7taras/LantronixSTALT/Datasheets/ENC28J60/enc28j60-ethernet-board-2_5.jpg

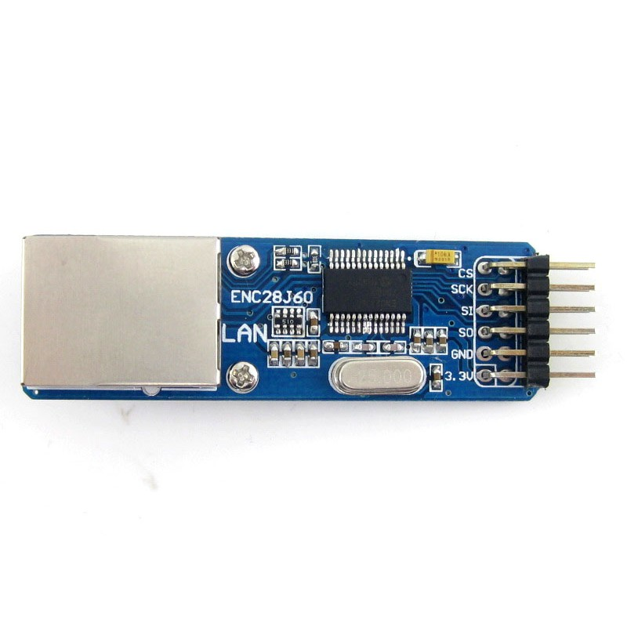
Datasheets/ENC28J60/enc28j60-ethernet-board-2_5.jpg
