7taras/LantronixSTALT/Datasheets/ENC28J60/enc28j60-ethernet-board_l_1_5.jpg

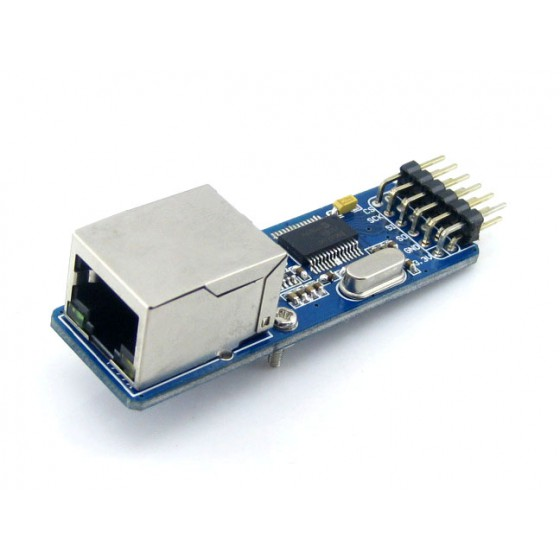
Datasheets/ENC28J60/enc28j60-ethernet-board_l_1_5.jpg
