7taras/LantronixSTALT/Project_v2/АСТА.468353.020 ПЭ3_00.pdf

Èçì. Ëèñò | | ¹ äîêóì. | Пîäï. | Äàòà
| | Ðàçðàá. | Кàлнàгóç | | 1.05.23 | Плàòà UART-Ethernet Пеðечень элеìенòîв | Ëèò. | Ëèñò | Ëèñòîв
Пðîв. | Аêáàшев | | 1.05.23 | | | | | 1 3
Í.êîнòð. | Цèðценñ
Óòв. | Íеñèн
ООО"СТАËТ" Èнв. ¹ ïîäл. Пîäï. è äàòà Âçàì. èнв. ¹ Èнв. ¹ äóáл. Пîäï. è äàòà Сïðàв. ¹ Пеðв. ïðèìен. | АСТА.468353.020 | A1 | Ðîçеòêà HR911105A, HanRun | 1
BQ1 | Квàðцевый ðеçîнàòîð HС-49S 12 МГц | 1
BQ2 | Квàðцевый ðеçîнàòîð HС-49S 25 МГц | 1

Кîнäенñàòîðы

C1 | Тàнòàлîвый SMD 47 ìêФ ±10% 10 Â Case B | 1
C2 | SMD 0805 X7R 1 ìêФ ±10% 50 Â | 1
C3 | Тàнòàлîвый SMD 47 ìêФ ±10% 10 Â Case B | 1
C4 | SMD 0805 X7R 1 ìêФ ±10% 50 Â | 1
C5,C6 | SMD 0805 NPO 18 ïФ ±5% 50 Â | 2
C7-C11 SMD 0805 X7R 0,1 ìêФ ±10% 50 Â | | 5
C12,C13 SMD 0805 NPO 18 ïФ ±5% 50 Â | | 2
C14 | SMD 0805 X7R 0,01 ìêФ ±10% 50 Â | 1
C15-C18 SMD 0805 X7R 0,1 ìêФ ±10% 50 Â | | 4
C19 | SMD 1206 X7R 4,7 ìêФ ±10% 50 Â | 1
C20,C21 SMD 0805 NPO 6800 ïФ ±5% 50 Â | | 2
C22 | SMD 0805 X7R 0,022 ìêФ ±10% 50 Â | 1
С23 | SMD 0805 X7R 0,01 ìêФ ±10% 50 Â | 1
C24 | SMD 1812 X7R 2200 ïФ ±10% 2 êÂ | 1
| Мèêðîñхеìы
DA1 | Сòàáèлèçàòîð AMS1117-3.3, AMS (SOT-223) | 1
DD1 | Мèêðîêîнòðîллеð STM32F103RB, | 1
| STMicroelecronics (LQFP-64 10x10mm)
DD2 | Мèêðîñхеìà W5500, Wiznet (LQFP-48 7x7mm) | 1
| | | АСТА.468353.020 ПЭ3

Пîç.
îáîçнàченèе
Íàèìенîвàнèе | Кîл. Пðèìечàнèе
Кîïèðîвàл | Фîðìàò A4

АСТА.468353.020 ПЭ3 | Ëèñò
| 2
HL1,Hl2 Свеòîäèîä KPTD-3216MGC | | 2
HL3 | Свеòîäèîä FYLS-1206SRC | 1
HL4 | Свеòîäèîä KPTD-3216MGC | 1
L1,L2 | Äðîññель BLM21BD121SN1D | 2
| Ðеçèñòîðы
R1 | SMD 0805 3 êОì ±5% | 1
R2,R3 | SMD 0805 33 Оì ±1% | 2
R4-R7 SMD 0805 10 êОì ±5% | | 4
R8 | SMD 0805 1 êОì ±5% | 1
R9 | SMD 0805 1 МОì ±5% | 1
R10-R12 SMD 0805 10 êОì ±5% | | 3
R13,R14 SMD 0805 1 êОì ±5% | | 2
R15 | SMD 0805 1 МОì ±5% | 1
R16-R18 SMD 0805 10 êОì ±5% | | 3
R19 | SMD 0805 12,4 êОì ±1% | 1
R20-R23 SMD 0805 33 Оì ±1% | | 4
R24-R27 SMD 0805 49,9 Оì ±1% | | 4
R28 | SMD 0805 10 Оì ±1% | 1
Èçì. Ëèñò R29,R30 SMD 0805 1 êОì ±5% | ¹ äîêóì. Пîäï. Äàòà Èнв. ¹ ïîäл. Пîäï. è äàòà Âçàì. èнв. ¹ Èнв. ¹ äóáл. Пîäï. è äàòà | 2
VD1 | Äèîä SMAJ5.0A (SMA (DO-214AC)) | 1
VT1,VT2 Тðàнçèñòîð BSS138 (SOT-23) | 2
X1 | Ðîçеòêà PBS-4 | 1
X2 | Âèлêà PLS-2 | 1 | не óñòàнàвлèвàòь

АСТА.468353.020 ПЭ3 | Ëèñò
3 Èçì. Ëèñò | ¹ äîêóì. | Пîäï. | Äàòà Èнв. ¹ ïîäл. Пîäï. è äàòà Âçàì. èнв. ¹ Èнв. ¹ äóáл. Пîäï. è äàòà

Пеðеìеные äàнные äля èñïîлненèй:

АСТА.468353.020

XP1 | Âèлêà IDC-10MS (BH-10) | 1
| АСТА.468353.020-01
XP1 | Âèлêà PLS-10 | 1
XP2 | Âèлêà PLS-2 | 1
