7taras/LantronixSTALT/Project_v2/АСТА.758723.038 УД_00.pdf

# АСТА.758723.038 УД

Изм. Лист | | № докум. | Подп. | Дата
| | Разраб. | Калнагуз | | Плата печатная Удостоверяющий лист | Лит. | Лист | Листов
Пров. | Акбашев | | | | | | | 1
Н.контр. | Цирценс
Утв. | Несин
ООО"СТАЛТ" Инв. № подл. Подп. и дата Взам. инв. № Инв. № дубл. Подп. и дата Справ. № Перв. примен. | АСТА.468353.020
Копировал | Формат A4
Обозначение | Разработал | Изготовил | Согласовано | Утвердил

АСТА.758723.038_V2.GBL
АСТА.758723.038_V2.GBO
АСТА.758723.038_V2.GBS
АСТА.758723.038_V2.GM4
АСТА.758723.038_V2.GTL
АСТА.758723.038_V2.GTO
АСТА.758723.038_V2.GTS
АСТА.758723.038_V2-Plated.txt
Калнагуз | Несин
