7taras/LantronixSTALT/Project2/АСТА.758723.039 УД_00.pdf

# АСТА.758723.039 УД

Изм. Лист | | № докум. | Подп. | Дата
| | Разраб. | Калнагуз | | 1.06.23 | Плата печатная Удостоверяющий лист | Лит. | Лист | Листов
Пров. | Акбашев | | 1.06.23 | | | | | | 1
Н.контр. | Цирценс
Утв. | Несин
ООО"СТАЛТ" Инв. № подл. Подп. и дата Взам. инв. № Инв. № дубл. Подп. и дата Справ. № Перв. примен. | АСТА.468353.020
Копировал | Формат A4
Обозначение | Разработал | Изготовил | Согласовано | Утвердил

АСТА.758723.039_V1.GBL
АСТА.758723.039_V1.GBO
АСТА.758723.039_V1.GBS
АСТА.758723.039_V1.GM4
АСТА.758723.039_V1.GTL
АСТА.758723.039_V1.GTO
АСТА.758723.039_V1.GTS
АСТА.758723.039_V1-Plated.txt
Калнагуз | Несин
