7taras/LantronixSTALT/Legacy/АСТА.468353.016 Плата Пи-Ethernet/АСТА.468353.016 ПЭ3_02.pdf

2 | Зам. АСТА.3062
Èçм. Ëèñò | | ¹ äîêóм. | Пîäï. | Äаòа
| | Ðаçðаá. | Кîнîвалîв | | | Плаòа ПÈ-Ethernet Пеðечень элеменòîв | Ëèò. | Ëèñò | Ëèñòîв
Пðîв. | Калнагóç | | | | О 1 | | | 1 2

Í.êîнòð. Цèðценñ
Óòв. | Гðèçóн
ООО "СТАËТ" Èнв. ¹ ïîäл. Пîäï. è äаòа Âçам. èнв. ¹ Èнв. ¹ äóáл. Пîäï. è äаòа | 8865 30.10.13 Сïðав. ¹ Пеðв. ïðèмен. | АСТА.468353.0¹6 | Кîнäенñаòîðы
С1-С3 | Танòалîвый SMD 10 мêФ ±10% 6,3 Â Size A | 3
С4,С5 | SMD 0805 X7R 0,1 мêФ ±10% 50 Â | 2
| Мèêðîñхемы
D1 | TXSO104EDR (SOIC-14) | 1
DA1 | LM1086ISX-3.3 (TO-263) | 1
| Свеòîäèîäы
HL1 | L-C150YCT | 1
HL2 | L-C150GCT | 1
| Ðеçèñòîðы
R1 | SMD 0805 10 êОм ±5% | 1
R2,R3 | SMD 0805 1 êОм ±5% | 2
R4,R5 | SMD 0805 10 êОм ±5% | 2
SB1 | Кнîïêа òаêòîвая 0643
| Пеðеменные äанные äля èñïîлненèй:
| АСТА.468353.016
С6,С7 | SMD 1210 NPO 220 ïФ ±5% 3 êÂ | 2
| Сîеäèнèòелè
XP1 | Âèлêа BH-10G | 1
XP2 | XP1002000-05R | 1
| | | АСТА.468353.016 ПЭ3

Пîç.
îáîçначенèе
Íаèменîванèе | Кîл. Пðèмечанèе
Кîïèðîвал | Фîðмаò A4

АСТА.468353.016 ПЭ3 | Ëèñò
| 2
2 | Íîв. АСТА.3062 Èнв. ¹ ïîäл. Пîäï. è äаòа Âçам. èнв. ¹ Èнв. ¹ äóáл. Пîäï. è äаòа | Èçм. Ëèñò | ¹ äîêóм. | Пîäï. | Äаòа ¹³⁴⁶⁶ ²⁶.06.18

АСТА.468353.016-01

| Сîеäèнèòелè
XP1,XP2 Âèлêа PLS-10 | | 2
XP3 | XP1002000-05R | 1

АСТА.468353.016-02

C6,C7 | SMD 1210 NPO 220 ïФ ±5% 3 êÂ | 2
| Сîеäèнèòелè
XP1 | Âèлêа BH-10G | 1
XP2 | XP1002000-05R | 1

Пîç.
îáîçначенèе
Íаèменîванèе | Кîл. Пðèмечанèе
Кîïèðîвал | Фîðмаò A4
