7taras/LantronixSTALT/Legacy/АСТА.468353.016 Плата Пи-Ethernet/АСТА.468353.016_04.pdf

| | | | | АСТА.468353.016
4 | Зам. АСТА.3062
Изм. Лист | | № докум. | Подп. | Дата
Разраб. | Коновалов | | | Плата ПИ-Ethernet | Лит. | Лист | Листов
Пров. | Калнагуз | | | | О 1 | | | 1 4
Т.контр. Михайлов | | | | | ООО "СТАЛТ"
Н.контр. Цицренс
Утв. | Гризун
Инв. № подл. | Подп. и дата | Взам. инв. № | Инв. № дубл. | Подп. и дата
8867 30.10.2013
| АСТА.468353.016- | Примечание
Справ. № | Перв. примен.
А4 | АСТА.468353.016 СБ | Сборочный чертеж | X | | (Л⁾ X | АСТА.425529.032 Код Лит.
A4 | -01 СБ | Сборочный чертеж | | X
А3 | АСТА.468353.016 Э3 | Схема электрическая | X | | X
| | принципиальная
A3 | -01 Э3 | Схема электрическая | | X
| | принципиальная
| | | | Документация
А4 | Зона | Поз. | АСТА.468353.016 ПЭ3 Обозначение | Перечень элементов Наименование | Кол. на исполн. X | X | X Формат
- 01 02
Копировал | Формат A4

АСТА.468353.016 | Лист
2

4 Зам. АСТА.3062
Изм. Лист | № докум. | Подп. | Дата

8867 30.10.2013
| АСТА.468353.016- | Примечание

Детали

А4 | 1 АСТА.754312.528 | Этикетка | 1
БЧ | 3 АСТА.758723.034 | Плата печатная | 1 | | 1
БЧ | 3 АСТА.758723.035 | Плата печатная | | 1

Прочие изделия

Конденсаторы

6 | Танталовый SMD 10 мкФ ±10% 6,3 В Size A | 3 | 3 | 3 | С1-С3 Формат | Зона | Поз. | Обозначение | Наименование | Кол. на исполн.
- 01 02
А4 | АСТА.468353.016 И1 | Инструкция по проверке | X | X | X
А4 | АСТА.758723.034 УД | Удостоверяющий лист | X | | X | Плата
А4 | АСТА.758723.035 УД | Удостоверяющий лист | | X | | Плата

3

### 4 Нов. АСТА.3062

8867 30.10.2013
| АСТА.468353.016- | Примечание
Зона | 17 Поз. | Обозначение | SMD 0805 1 кОм ±5% Наименование Микросхемы | Кол. на исполн. 2 | 2 | 2 | R2,R3 Формат
| 10 | | TXS0104EDR (SOIC-14) | 1 | 1 | 1 | D1
| 11 | | LM1086ISX-3.3 (TO-263) | 1 | 1 | 1 | DA1
| Светодиоды
13 | L-C150YCT | 1 | 1 | 1 | HL1
14 | L-C150GCT | 1 | 1 | 1 | HL2
| Резисторы
16 | SMD 0805 10 кОм ±5% | 3 | 3 | 3 | R1,R4,R5
- 01 02
| 7 | SMD 0805 X7R 0,1 мкФ ±10% 50 В | 2 | 2 | 2 | С4,С5
| 8 | SMD 1210 NPO 220 пФ ±5% 3 кВ | 2 | | 2 | С6,С7

4

### 4 Нов. АСТА.3062

8867 30.10.2013
| АСТА.468353.016- | Примечание
| Соединители
22 | Вилка BH-10G | 1 | | 1 | XP1 к баз.,-02
23 | XP1002000-05R | 1 | 1 | 1 | XP2 к баз.,-02,
| | | | | XP3 к -01
- 01 02
| | 20 | | Кнопка тактовая 0643 | 1 | 1 | 1 | SB1
| Зона | 24 Поз. | Обозначение | Вилка PLS-10 Наименование | Кол. на исполн. | 2 | | XP1, XP2 к -01 Формат
