7taras/LantronixSTALT/Legacy/АСТА.468353.018 Плата ПИ-Ethernet-MX/АСТА.468353.018 ПЭ3_00.pdf

Èçì. Ëèñò | | ¹ äîêóì. | Пîäï. | Äàòà
| | Ðàçðàá. | Кàлнàгóç | | 18.11.19 | Плàòà ПÈ-Ethernet-MX Пеðечень элеìенòîв | Ëèò. | Ëèñò | Ëèñòîв
Пðîв. | Кîнîвàлîв | | 18.11.19 | | | | | 1 2

Í.êîнòð. Цèðценñ
Óòв. | Гðèçóн
ООО"СТАËТ" Èнв. ¹ ïîäл. Пîäï. è äàòà Âçàì. èнв. ¹ Èнв. ¹ äóáл. Пîäï. è äàòà Сïðàв. ¹ Пеðв. ïðèìен. | АСТА.468353.0¹8 | A1, A2 Óñòðîйñòвî XP1002000-05R | 2
| Кîнäенñàòîðы
C1, C2 SMD 1210 NP0 220 ïФ ±5% 3 êÂ | | 2
С3 | Тàнòàлîвый SMD 22 ìêФ ±10% 6,3 Â Case A | 1
C4 | SMD 0805 X7R 1 ìêФ ±10% 50 Â | 1
C5 | SMD 0805 X7R 0,1 ìêФ ±10% 50 Â | 1
С6 | Тàнòàлîвый SMD 22 ìêФ ±10% 6,3 Â Case A | 1
C7 | SMD 0805 X7R 1 ìêФ ±10% 50 Â | 1
C8-C13 SMD 0805 X7R 0,1 ìêФ ±10% 50 Â | | 6
| Мèêðîñхеìы
DA1 | AMS1117 (SOT-223) | 1
DD1 | 74HC257D (SOIC-16) | 1
DD2 | TXS0104EPWR (TTSOP-14) | 1
| Свеòîäèîäы
HL1,HL2 L-C150GCT | | 2
HL3,HL4 L-C150YCT | | 2
HL5-HL7 L-C150GCT | | 3
HL8,HL9 L-C150YCT | | 2
| Ðеçèñòîðы
R1 | SMD 0805 3 êОì ±5% | 1
R2,R3 | SMD 0805 10 êОì ±5% | 2
R4-R6 SMD 0805 3 êОì ±5% | | 3
R7 | SMD 0805 220 Оì ±1% | 1
R8 | SMD 0805 360 Оì ±1% | 1
| | | АСТА.468353.018 ПЭ3

Пîç.
îáîçнàченèе
Íàèìенîвàнèе | Кîл. Пðèìечàнèе
Кîïèðîвàл | Фîðìàò A4

АСТА.468353.018 ПЭ3 | Ëèñò
2 Èнв. ¹ ïîäл. Пîäï. è äàòà Âçàì. èнв. ¹ Èнв. ¹ äóáл. Пîäï. è äàòà | Èçì. Ëèñò | ¹ äîêóì. | Пîäï. | Äàòà
SB1,SB2 Кнîïêà òàêòîвàя 0643 | 2
| Äèîäы
VD1 | SMAJ5.0A (SMA (DO-214AC)) | 1
VD2 | SMLVT3V3 (SMB (DO-214AA)) | 1
XP1 | Âèлêà IDC-10MS (BH-10) | 1
Пîç. îáîçнà-ченèе | Íàèìенîвàнèе | Кîл. Пðèìечàнèе
R9-R13 SMD 0805 1 êОì ±5% | | 5
R14-R16 SMD 0805 10 êОì ±5% | | 3
R17 | SMD 0805 1 êОì ±5% | 1
R18 | SMD 0805 10 êОì ±5% | 1
R19 | SMD 0805 1 êОì ±5% | 1
Кîïèðîвàл | Фîðìàò A4
