7taras/LantronixSTALT/Legacy/АСТА.468353.018 Плата ПИ-Ethernet-MX/АСТА.468353.018_00.pdf

## АСТА.468353.018

Изм. Лист | | № докум. | Подп. | Дата
Разраб. | Калнагуз | | 18.11.19 | Плата ПИ-Ethernet-MX | Лит. | Лист | Листов
Пров. | Коновалов | | 18.11.19 | | | | | 1 4
Т.контр. Михайлов | | | | | ООО"СТАЛТ"
Н.контр. Цирценс
Утв. | Гризун
| | | | Документация
Инв. № подл. А4 | Зона | Поз. | Подп. и дата Взам. инв. № Инв. № дубл. АСТА.758723.037 УД Обозначение | Подп. и дата Удостоверяющий лист Наименование | Кол. на исполн. X | (Л⁾ X Формат | Справ. № | Перв. примен. Код Лит.
A3 | ACTA.468353.018 СБ | Сборочный чертеж | X | X
A3 | ACTA.468353.018 Э3 | Схема электрическая | X | X
| | принципиальная
А4 | ACTA.468353.018 ПЭ3 | Перечень элементов | X | X
А4 | ACTA.468353.018 И1 | Инструкция по настройке | X | X
| | и проверке
- 01
АСТА.468353.018- | Примечание
Копировал | Формат A4

АСТА.468353.018 | Лист
2
Изм. Лист | № докум. | Подп. | Дата
Инв. № подл. | Подп. и дата | Взам. инв. № | Инв. № дубл. | Подп. и дата

Детали

A4 | 1 АСТА.754312.520 | Этикетка | 1 | 1
БЧ | 2 АСТА.758723.037 | Плата печатная | 1 | 1

Прочие изделия

18 | Устройство XP1002000-05R | 2 | 2 | A1,A2
| Конденсаторы
20 | SMD 0805 X7R 0,1 мкФ ±10% 50 В | 7 | 7 | C5,C8-C13
21 | SMD 0805 X7R 1 мкФ ±10% 50 В | 2 | 2 | C4,C7 Формат | Зона | Поз. | Обозначение | Наименование | Кол. на исполн.
- 01
АСТА.468353.018- | Примечание

| | | 3 Изм. Лист
№ докум. | Подп. | Дата
24 | Танталовый SMD 22 мкФ | 2 | 2 | C3,C6
| ±10% 6,3 В Case A

Микросхемы

30 | 74HC257D (SOIC-16) | 1 | 1 | DD1
32 | AMS1117 (SOT-223) | 1 | 1 | DA1
34 | TXS0104EPWR (TTSOP-14) | 1 | 1 | DD2
40 | Светодиод L-C150GCT | 5 | 5 | HL1,HL2,HL5-HL7
42 | Светодиод L-C150YCT | 4 | 4 | HL3,HL4,HL8,HL9

Резисторы

50 | SMD 0805 220 Ом ±1% | 1 | 1 | R7
51 | SMD 0805 360 Ом ±1% | 1 | 1 | R8 Формат | Зона | Поз. | Обозначение | Наименование | Кол. на исполн.
- 01
| 22 | SMD 1210 NP0 220 пФ ±5% 3 кВ | 2 | 2 | C1,C2
АСТА.468353.018- | Примечание

4
Изм. Лист | № докум. | Подп. | Дата
53 | SMD 0805 1 кОм ±5% | 7 | 7 | R9-R13,R17,R19
54 | SMD 0805 3 кОм ±5% | 4 | 4 | R1,R4-R6
56 | SMD 0805 10 кОм ±5% | 6 | 6 | R2,R3,R14-R16,R18
60 | Кнопка тактовая 0643 | 2 | 2 | SB1,SB2

Диоды

70 | SMAJ5.0A (SMA (DO-214AC)) | 1 | 1 | VD1
71 | SMLVT3V3 (SMB (DO-214AA)) | 1 | 1 | VD2
90 | Вилка IDC-10MS (BH-10) | 1 | 1 | XP1 Формат | Зона | Поз. | Обозначение | Наименование | Кол. на исполн.
- 01
АСТА.468353.018- | Примечание
