7taras/LantronixSTALT/Legacy/АСТА.468353.019 Плата UART-RS-485x2/АСТА.468353.019 ПЭ3_01.pdf

1 | Зам.
Èçм. Ëèñò | | ¹ äîêóм. | Пîäï. | Äаòа
| | Ðаçðаá. | Калнагóç | | 01.07.21 | Плаòа UART-RS-485x2 Пеðечень элеменòîв | Ëèò. | Ëèñò | Ëèñòîв
Пðîв. | Аêáашев | | 01.07.21 | | | | | 1 2

Í.êîнòð. Цèðценñ
Óòв. | Кашèн
ООО"СТАËТ" Èнв. ¹ ïîäл. Пîäï. è äаòа Âçам. èнв. ¹ Èнв. ¹ äóáл. Пîäï. è äаòа Сïðав. ¹ Пеðв. ïðèмен. | АСТА.468353.0¹9 | BQ1 | Кваðцевый ðеçîнаòîð HT-49SM 14,7456 МГц | 1
| Кîнäенñаòîðы
C1,C2 | ELV 33 мêФ ±20% 10 Â Size A | 2
C3-C5 SMD 0805 X7R 1 мêФ ±10% 50 Â | | 3
C6 | Танòалîвый SMD 10 мêФ ±10% 6,3 Â Case A | 1
C7,C8 | SMD 0603 X7R 1 ïФ ±10% 50 Â | 2
C9 | SMD 0805 X7R 1 мêФ ±10% 50 Â | 1
C10,C11 ELV 33 мêФ ±20% 10 Â Size A | | 2
C12,C13 SMD 0603 X7R 1 ïФ ±10% 50 Â | | 2
C14,C15 SMD 0805 X7R 1 мêФ ±10% 50 Â | | 2
C16 | SMD 0603 X7R 0,1 мêФ ±10% 50 Â | 1
C17,C18 SMD 0603 NPO 15 ïФ ±5% 50 Â | | 2
C19-C25 SMD 0603 X7R 0,1 мêФ ±10% 50 Â | | 7
C26,C27 SMD 1812 X7R 2200 ïФ ±10% 2 êÂ | | 2
C28,C29 SMD 0603 X7R 0,1 мêФ ±10% 50 Â | | 2
| Мèêðîñхемы
DA1 | AMS1117-3.3 (SOT-223) | 1
DD1 | STM32F103RB (LQFP-64 10x10mm) | 1
DD2,DD3 ADuM1301ARW (SO-16W) | | 2
DD4,DD5 ADM483EAR (SOIC-8) | | 2
FU1-FU4 Пðеäîхðанèòель MF-R017 | 4
| Свеòîäèîäы
HL1 | L-C191GCT | 1
HL2 | L-C191YCT | 1
| | | АСТА.468353.019 ПЭ3

Пîç.
îáîçначенèе
Íаèменîванèе | Кîл. Пðèмечанèе
Кîïèðîвал | Фîðмаò A4

АСТА.468353.019 ПЭ3 | Ëèñò
| 2
1 | Зам. Èнв. ¹ ïîäл. Пîäï. è äаòа Âçам. èнв. ¹ Èнв. ¹ äóáл. Пîäï. è äаòа | Èçм. Ëèñò | ¹ äîêóм. | Пîäï. | Äаòа
L1-L4 | Äðîññель LQH43CN100K03 | 4
| Ðеçèñòîðы
R1-R4 SMD 0603 22 Ом ±5% | | 4
R5-R8 SMD 0603 10 êОм ±5% | | 4
R9-R14 SMD 0603 1 êОм ±5% | | 6
R15-R18 SMD 0603 10 êОм ±5% | | 4
R19-R22 SMD 0603 30 êОм ±5% | | 4
R23-R26 SMD 1206 560 Ом ±5% | | 4
R27-R30 SMD 1206 120 Ом ±5% | | 4
U1,U2 | DC/DC ïðеîáðаçîваòель AM1S-0505SH30Z | 2
| Äèîäы
VD1 | SMAJ5.0A (SMA (DO-214AC)) | 1
VD2-VD5 SMAJ6.0CA (SMA (DO-214AC)) | | 4
VT1,VT2 Тðанçèñòîð BSS138 (SOT-23) | 2
| Сîеäèнèòелè
X1,X2 | Âèлêа ECH350R-03P | 2
XP1 | Âèлêа IDC-10MS (BH-10) | 1
XP2-XP7 Âèлêа PLS-2 | | 6
XS1 | Ðîçеòêа PBS-6 | 1
XS2-XS7 Мèнäжамïеð MJ-G 2,54 мм | | 6
XT1,XT2 Клеммнèê EC350V-03P | | 2
Пîç. îáîçна-ченèе | Íаèменîванèе | Кîл. Пðèмечанèе
HL3 | L-C191GCT | 1
HL4 | L-C191YCT | 1
HL5 | L-C191GCT | 1
HL6 | L-C191YCT | 1
Кîïèðîвал | Фîðмаò A4
