7taras/LantronixSTALT/Legacy/АСТА.468353.019 Плата UART-RS-485x2/АСТА.468353.019_01.pdf

| | | | | АСТА.468353.019
1 | Зам.
Изм. Лист | | № докум. | Подп. | Дата
| | Разраб. | Калнагуз | | 01.07.21 | Плата UART-RS-485x2 | Лит. | Лист | Листов
Пров. | Акбашев | | 01.07.21 | | | | | 1 3
Т.контр. Михайлов
Н.контр. Цирценс
Утв. | Кашин
ООО"СТАЛТ" Инв. № подл. Подп. и дата Взам. инв. № Инв. № дубл. Подп. и дата Справ. № Перв. примен. | Документация
A3 | | | АСТА.468353.019 СБ | Сборочный чертеж
A3 | | | АСТА.468353.019 Э3 | Схема электрическая
| | | | принципиальная
А4 | | | АСТА.468353.019 ПЭ3 | Перечень элементов
А4 | | | АСТА.468353.019 И1 | Инструкция по настройке
| Зона | 12 Поз. | Обозначение | ELV 33 мкФ ±20% 10 В Size A Наименование и проверке | 4 Кол. | C1,C2,C10,C11 Формат Приме-
А4 | | | АСТА.468353.019 УД | Удостоверяющий лист | | Прошивка
А4 | | | АСТА.758724.062 УД | Удостоверяющий лист | | Плата

Детали

A4 | 1 АСТА.754312.520 | Этикетка | 1
БЧ | 2 АСТА.758724.062 | Плата печатная | 1

Прочие изделия

10 | Кварцевый резонатор HT-49SM 14,7456 МГц | 1 | BQ1
| Конденсаторы

чание

Копировал | Формат A4

АСТА.468353.019 | Лист
14 | SMD 0603 X7R 1 пФ ±10% 50 В | 4 | C7,C8,C12,C13
15 | SMD 0603 NPO 15 пФ ±5% 50 В | 2 | C17,C18
16 SMD 0603 X7R 0,1 мкФ ±10% 50 В 10 C16,C19-C25,
| | | C28,C29
18 | SMD 0805 X7R 1 мкФ ±10% 50 В | 6 | C3-C5,C9,C14,C15
20 | SMD 1812 X7R 2200 пФ ±10% 2 кВ | 2 | C26,C27
22 | Танталовый SMD 10 мкФ ±10% 6,3 В Case A | 1 | C6

Микросхемы

30 | ADuM1301ARW (SO-16W) | 2 | DD2,DD3
31 | ADM483EAR (SOIC-8) | 2 | DD4,DD5
33 | AMS1117-3.3 (SOT-223) | 1 | DA1
34 | STM32F103RB (LQFP-64 10x10mm) | 1 | DD1
| 40 | | Предохранитель MF-R017 | 4 | FU1-FU4
Изм. Лист | | № докум. Подп. Дата | | | 2 Инв. № подл. Подп. и дата Взам. инв. № Инв. № дубл. Подп. и дата

Светодиоды

42 | L-C191GCT | 3 | HL1,HL3,HL5
43 | L-C191YCT | 3 | HL2,HL4,HL6
46 | Дроссель LQH43CN100K03 | 4 | L1-L4 Формат | Зона | Поз. | Обозначение | Наименование | Кол. | Приме-

АСТА.468353.019 | Лист
| 3
Изм. Лист 1 | Зам. Инв. № подл. Подп. и дата Взам. инв. № Инв. № дубл. Подп. и дата | № докум. Подп. Дата

Резисторы

50 | SMD 0603 22 Ом ±5% | 4 | R1-R4
51 | SMD 0603 1 кОм ±5% | 6 | R9-R14
52 | SMD 0603 10 кОм ±5% | 8 | R5-R8,R15-R18
53 | SMD 0603 30 кОм ±5% | 4 | R19-R22
54 | SMD 1206 120 Ом ±5% | 4 | R27-R30
55 | SMD 1206 560 Ом ±5% | 4 | R23-R26
60 | DC/DC преобразователь AM1S-0505SH30Z | 2 | U1,U2

Диоды

64 | SMAJ5.0A (SMA (DO-214AC)) | 1 | VD1
65 | SMAJ6.0CA (SMA (DO-214AC)) | 4 | VD2-VD5
68 | Транзистор BSS138 (SOT-23) | 2 | VT1,VT2

Соединители

70 | Вилка ECH350R-03P | 2 | X1,X2
71 | Вилка IDC-10MS (BH-10) | 1 | XP1
72 | Вилка PLS-2 | 6 | XP2-XP7
74 | Клеммник EC350V-03P | 2 | XT1,XT2
75 | Минджампер MJ-G 2,54 мм | 6 | XS2-XS7
76 | Розетка PBS-6 | 1 | XS1 Формат | Зона | Поз. | Обозначение | Наименование | Кол. | Приме-
