7taras/LantronixSTALT/Datasheets/DP83848/dp83848-ethernet-board-1.jpg

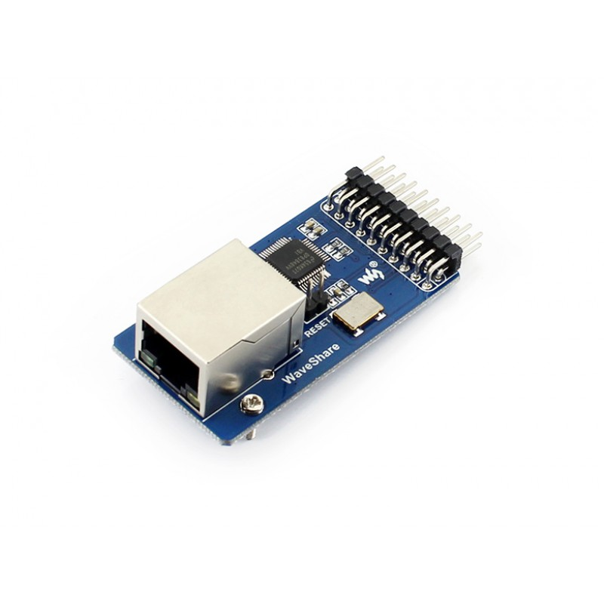
Datasheets/DP83848/dp83848-ethernet-board-1.jpg
