7taras/LantronixSTALT/Datasheets/DP83848/dp83848-ethernet-board-4_6.jpg

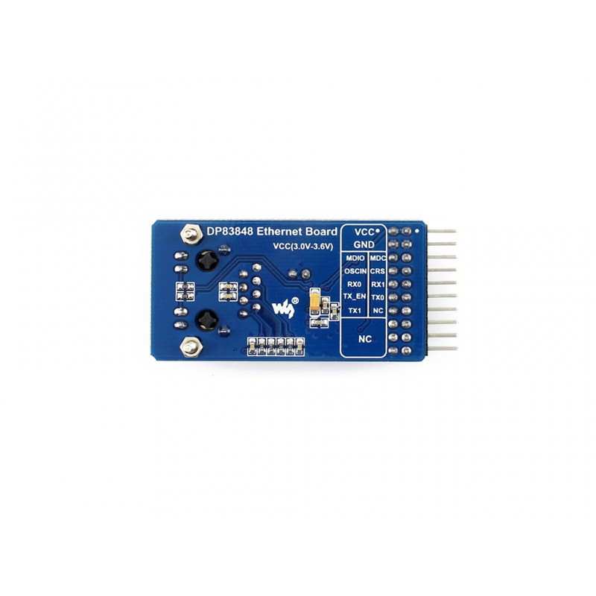
Datasheets/DP83848/dp83848-ethernet-board-4_6.jpg
