7taras/LantronixSTALT/Datasheets/W5500/5w9ntoywztq91.png

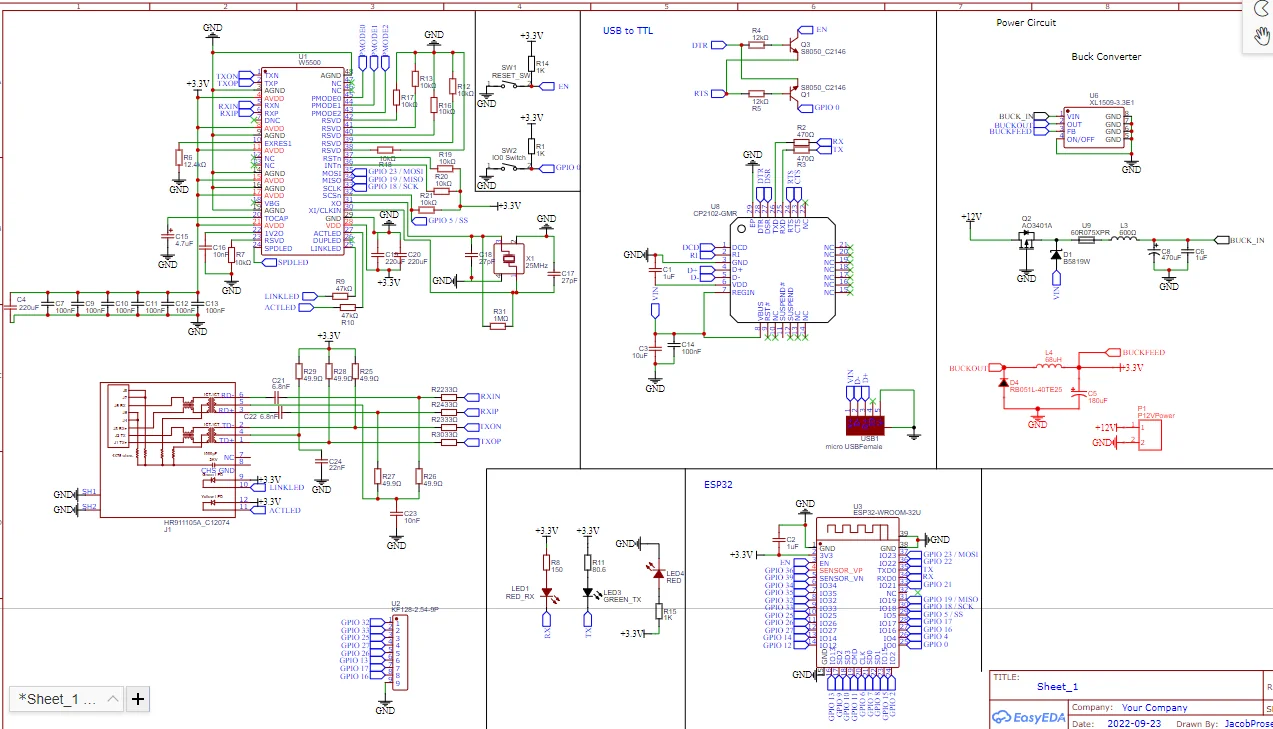
Datasheets/W5500/5w9ntoywztq91.png
