7taras/LantronixSTALT/Project/BOM.xlsx

Наименование | Кол-во на плату | Всего | Ссылка
Pозетка на плату HR911105A, HanRun | 1 | 2 | https://sds.compel.ru/infosheet/HANRUN/HR911105A
Резонатор кварцевый HC-49S 25 МГц | 1 | 2 | https://sds.compel.ru/infosheet/SJK/ECN-HC49S-25.000MHz-16pF
Резонатор кварцевый HC-49S 14,7456 МГц | 1 | 2 | https://sds.compel.ru/infosheet/TXC/9B-14.7456MAAJ-B
Стабилизатор AMS1117-3.3, AWM | 1 | 2 | https://sds.compel.ru/infosheet/YOUTAI/AMS1117-3.3
Микроконтролер STM32F103RB, STMicroelectronics | 1 | 2 | https://sds.compel.ru/infosheet/ST/STM32F103RBT6
Микросхема W5500, Wiznet | 1 | 2 | https://sds.compel.ru/infosheet/WIZNET/W5500
Отладочный модуль с W5500 |  | 2 | https://sds.compel.ru/infosheet/WIZNET/W5500IO-P
