7taras/LantronixSTALT/Project_v2/АСТА.468353.020 _Э3_00.pdf

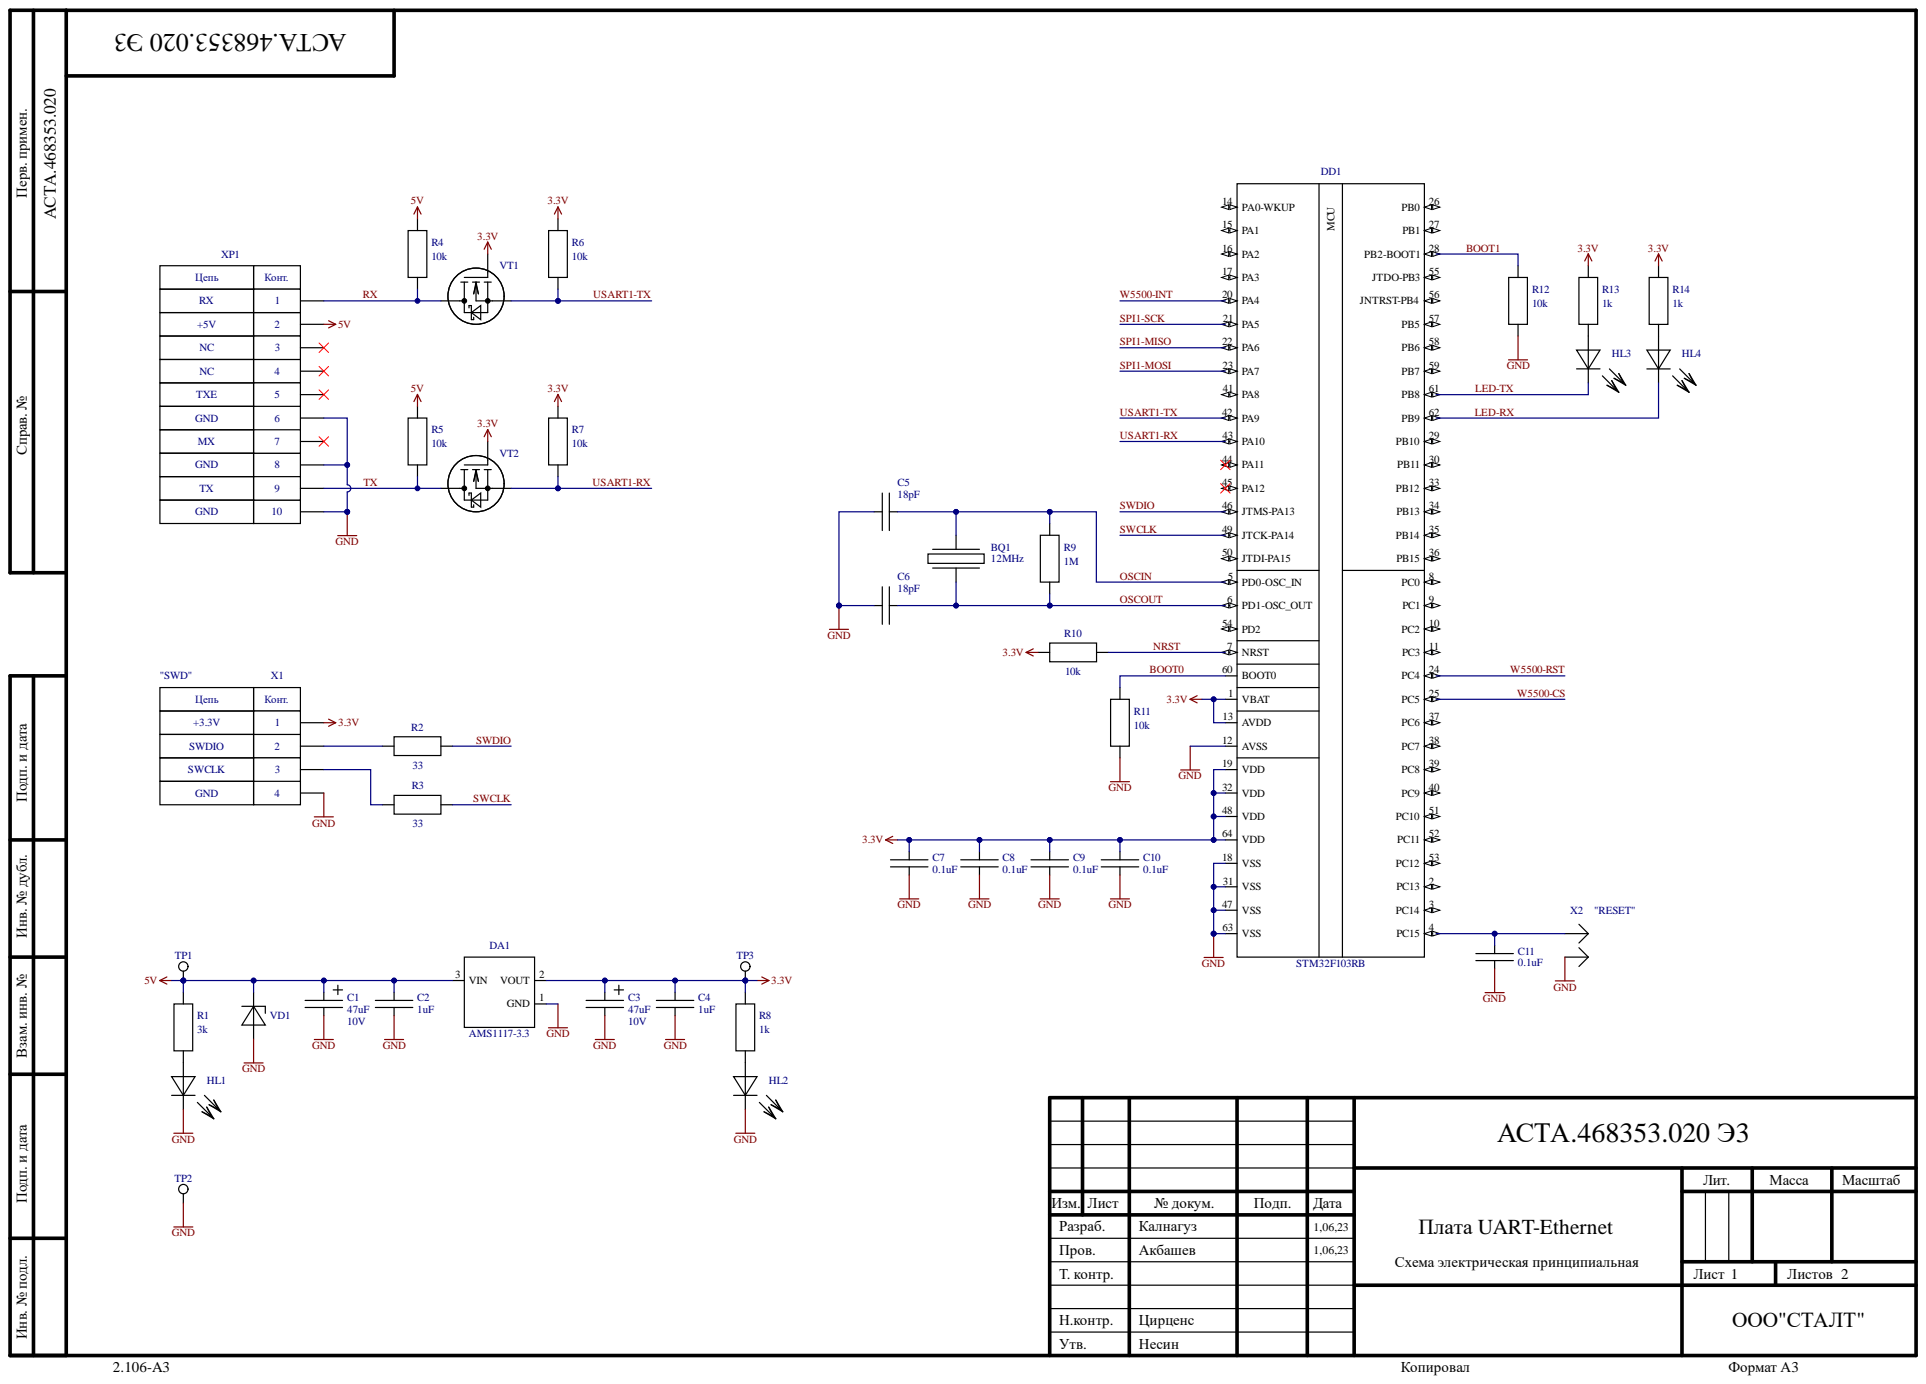
[picture p6: page 1]

Инв. № подл. Инв. № дубл. Подп. и дата Взам. инв. № Подп. и дата Перв. примен. Справ. №

PA 0 -W KU P PA 1 PA 2 PA 3 PA 4 PA 5 PA 6 PA 7 PA 8 PA 9 PA 1 0 PA 1 1 PA 1 2 J TMS -PA 1 3 J TCK -PA 1 4 J T D I -PA 1 5 | PB 0 PB 1 PB2-B O O T 1 J T D O -PB 3 J N TRS T-PB 4 PB 5 PB 6 PB 7 PB 8 PB 9 PB 1 0 PB 1 1 PB 1 2 PB 1 3 PB 1 4 PB 1 5

MX GND TX GND GND NC TXE NC

АСТ А.468353.020 Э 3

Плат а UAR T-Ethernet Сх е м а э л ектрич е с к ая принципиа льна я | Лит . | Ма с с а | б Ма с шта

Из м . | Лис т | № до ку м . | Подп . | Дата
Р а з р а б . | | Ка лнагу з | | 1,0 6,2 3
. Пр о в | | Акба ш е в | | 1,0 6,2 3
Т. контр . | | | | | Лис т 1 | Листо в 2

ООО "СТАЛТ "

Н . контр . | Цирценс
Утв . | Не син

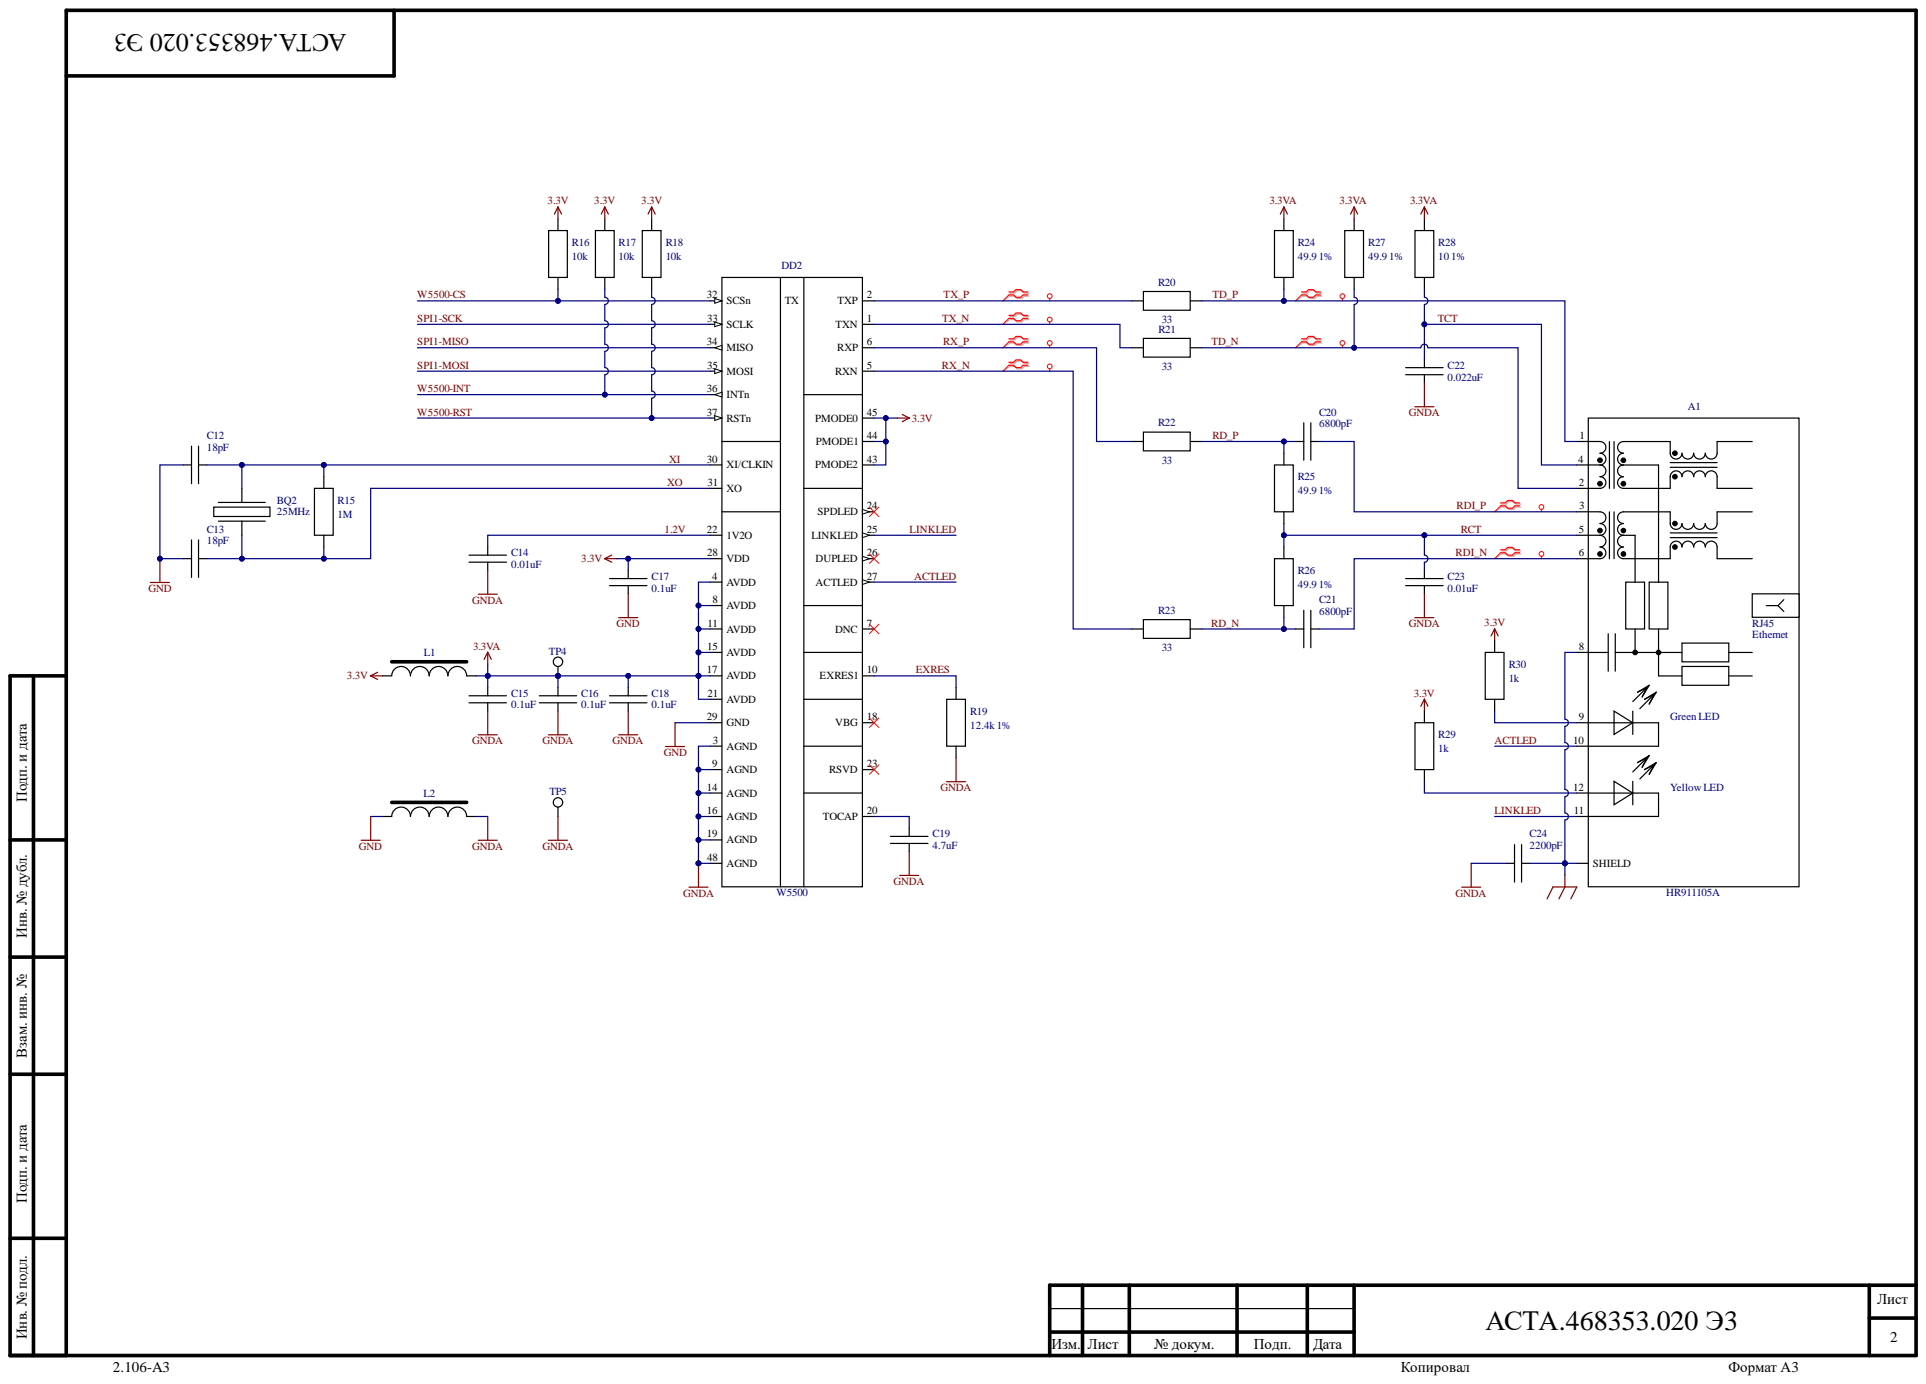
[picture p7: page 2]

XI/CL KIN X O | | | 4 | 3 | LIN K LE D

1 . 2 V 2 2 | | | SPD LE D LIN K LE D D U PLE D ACT LE D

8 | | | 2 | 6 ACT LE D

Инв. № подл. Инв. № дубл. Подп. и дата Взам. инв. № Подп. и дата
