7taras/LantronixSTALT/STLINK/Project Outputs for PCB_Project/STLINK-SWD.pdf

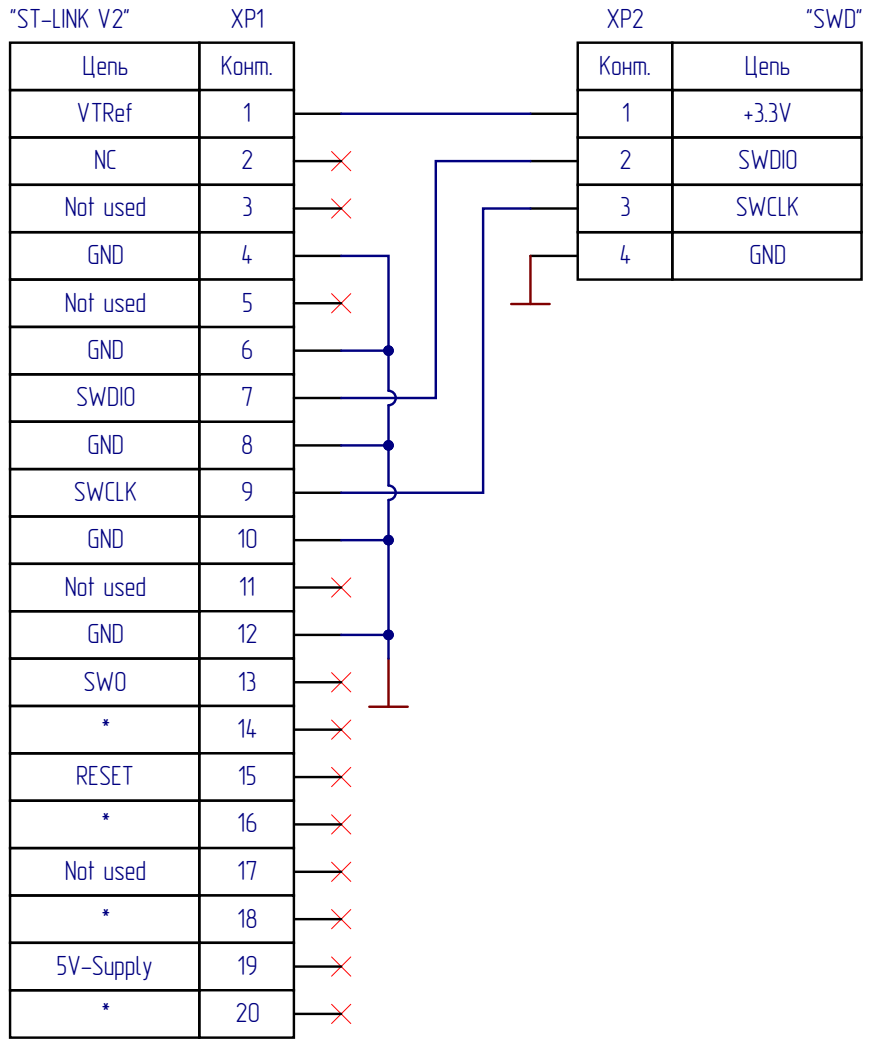
[picture p8: page 1]

Not used | 3 | 3 | SWCLK
GND | 4 | 4 | GND
Not used | 5
GND | 6
SWDIO | 7
GND | 8
SWCLK | 9
GND | 10
Not used | 11
GND | 12
SWO | 13
* | 14
RESET | 15
* | 16
Not used | 17
* | 18
5V-Supply | 19
* | 20
