7taras/LantronixSTALT/STLINK/Project Outputs for PCB_Project/STLINK.PDF

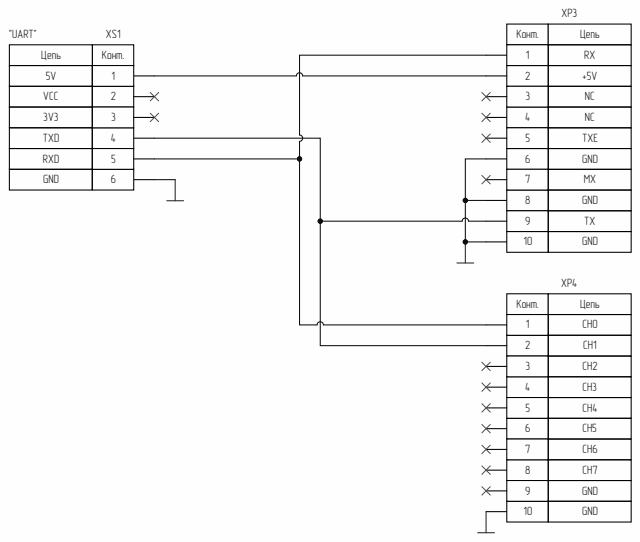
[picture p9: page 1]

8 | GND
9 | TX
10 | GND

Конт. | Цепь
1 | CH0
2 | CH1
3 | CH2
4 | CH3

5 | CH4
6 | CH5
7 | CH6
8 | CH7
9 | GND
