7taras/LantronixSTALT/Project2/АСТА.468353.020-01 СБ_00.pdf

1

А

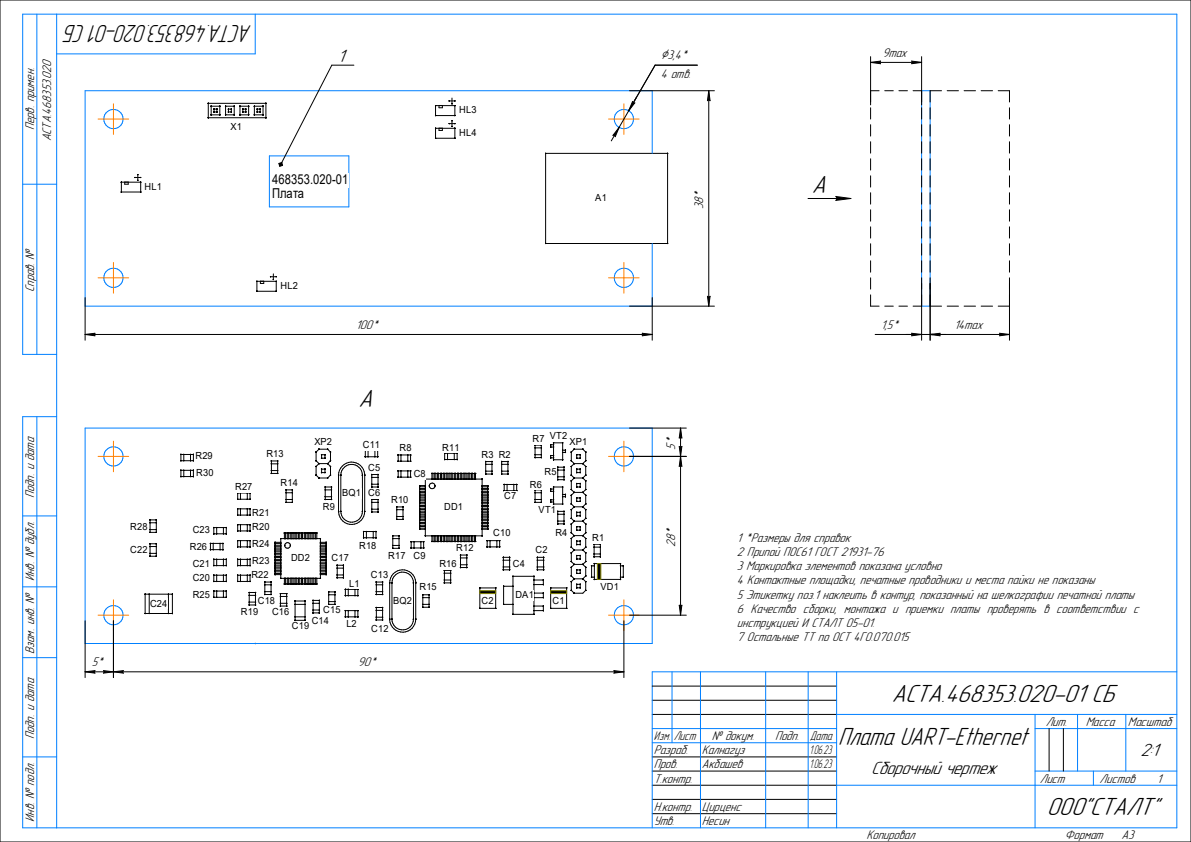
[picture p10: page 1]

1 Инв. № подл. Подп. и дата Взам. инв. № Инв. № дубл. Подп. и дата Справ. № Перв. примен. АСТА.468353.020

1 *Размеры для справок
2 Припой ПОС61 ГОСТ 21931-76
3 Маркировка элементов показана условно
4 Контактные площадки, печатные проводники и места пайки не показаны
5 Этикетку поз.1 наклеить в контур, показанный на шелкографии печатной платы
6 Качество сборки, монтажа и приемки платы проверять в соответствии с
инструкцией И СТАЛТ 05-01.
7 Остальные ТТ по ОСТ 4ГО.070.015
