7taras/LantronixSTALT/Legacy/АСТА.468353.016 Плата Пи-Ethernet/АСТА.468353.016 Э3.pdf

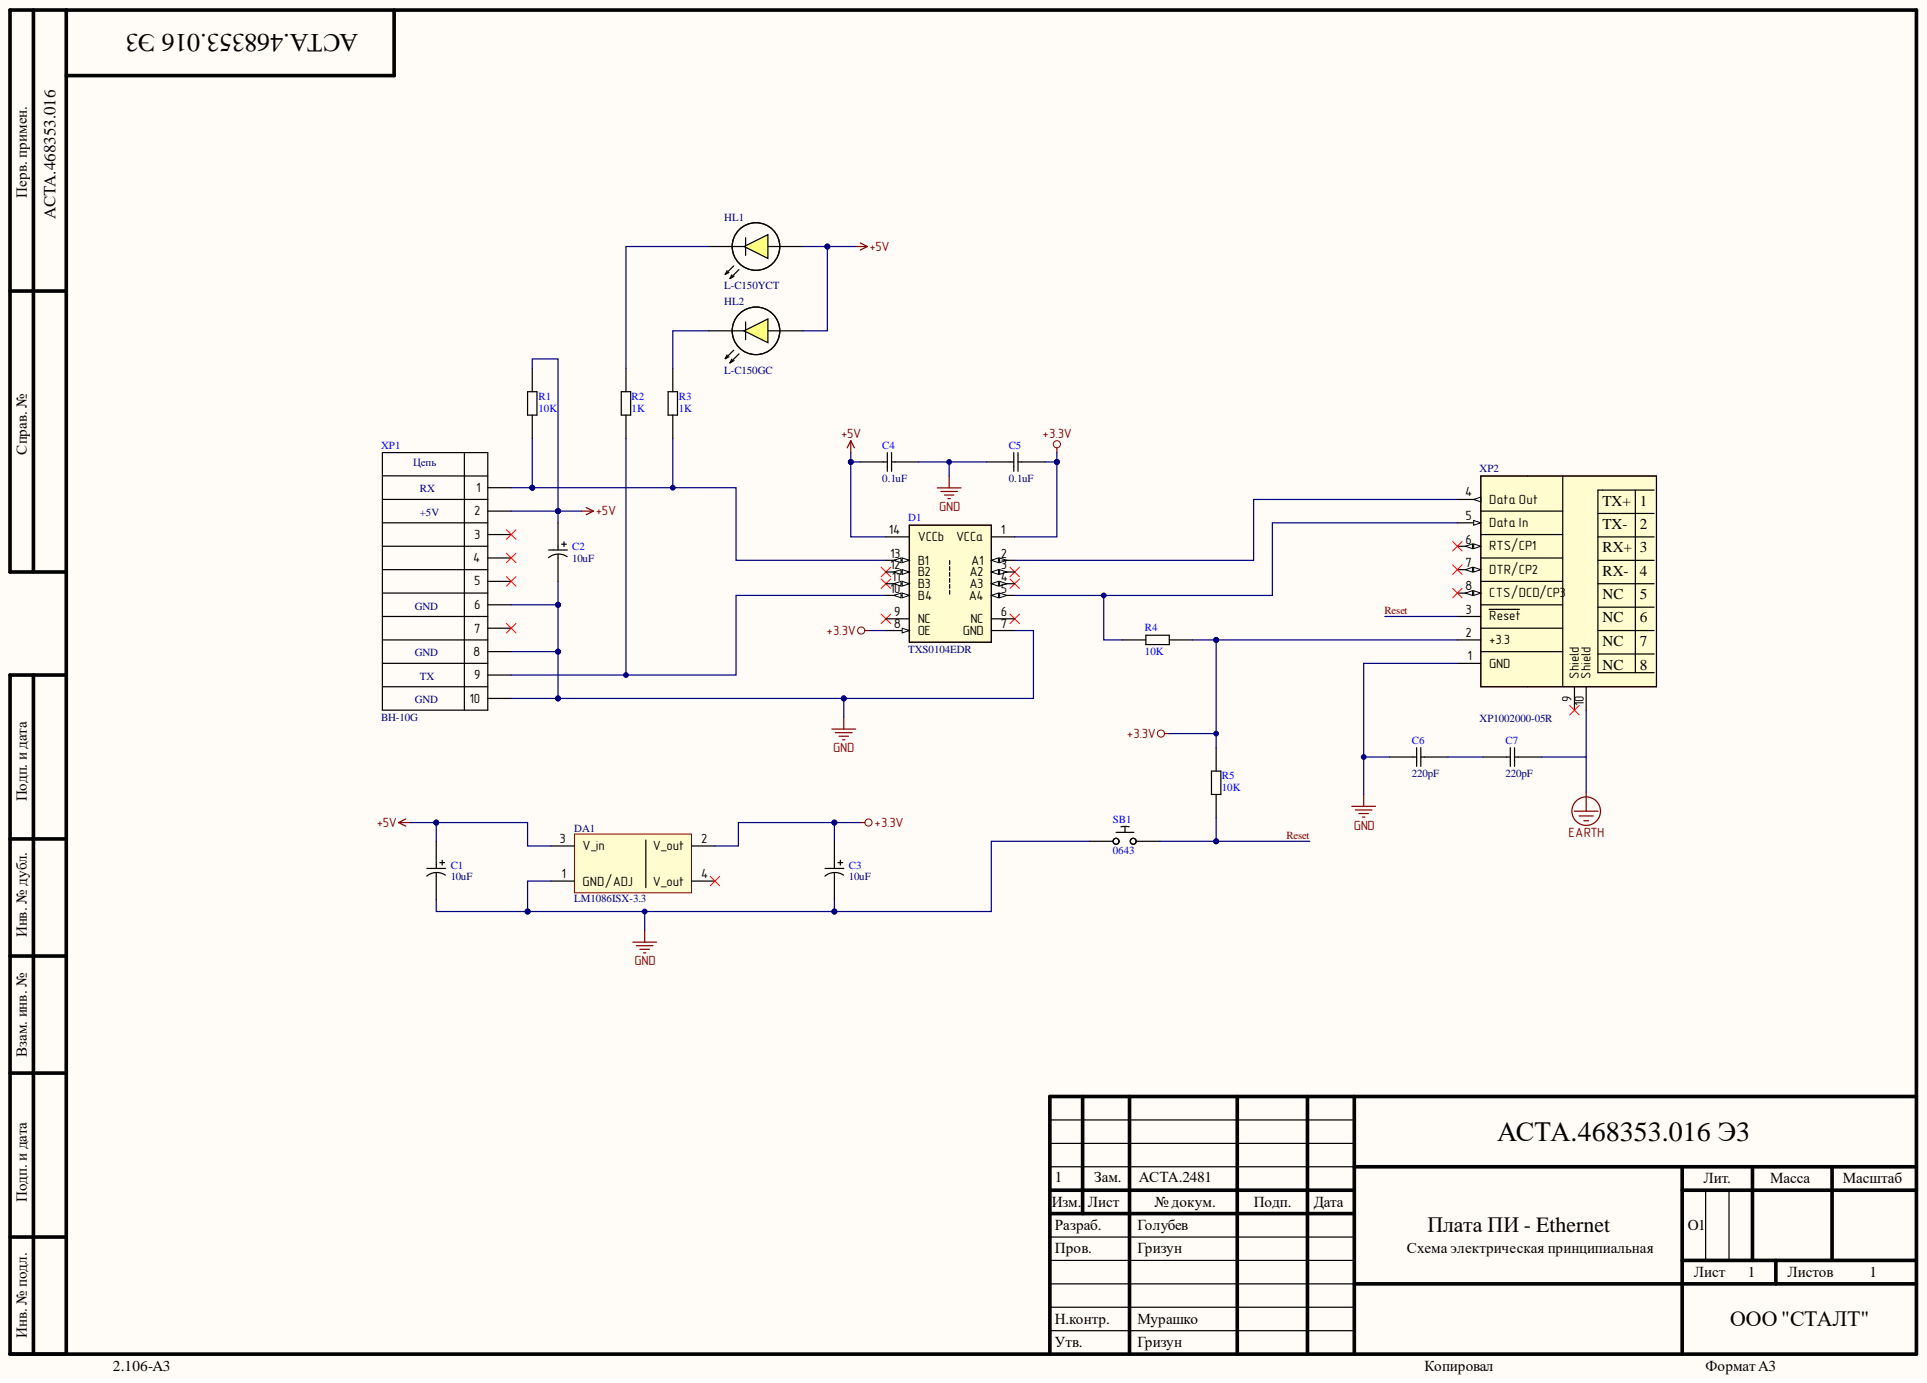
[picture p15: page 1]

Инв. № подл. Инв. № дубл. Подп. и дата Взам. инв. № Подп. и дата Перв. примен. Справ. №

GND | 8

АСТА.468353.016 Э3

1 | Зам. | АСТА.2481 | | | Плата ПИ - Ethernet Схема электрическая принципиальная | Лит. | Масса | Масштаб
Изм. | Лист | № докум. | Подп. | Дата | | O1
Разраб. | | Голубев
Пров. | | Гризун

Лист 1 | Листов 1

Н.контр. | Мурашко
Утв. | Гризун

ООО "СТАЛТ"
