7taras/LantronixSTALT/Legacy/АСТА.468353.018 Плата ПИ-Ethernet-MX/АСТА.468353.018 Э3_00.pdf

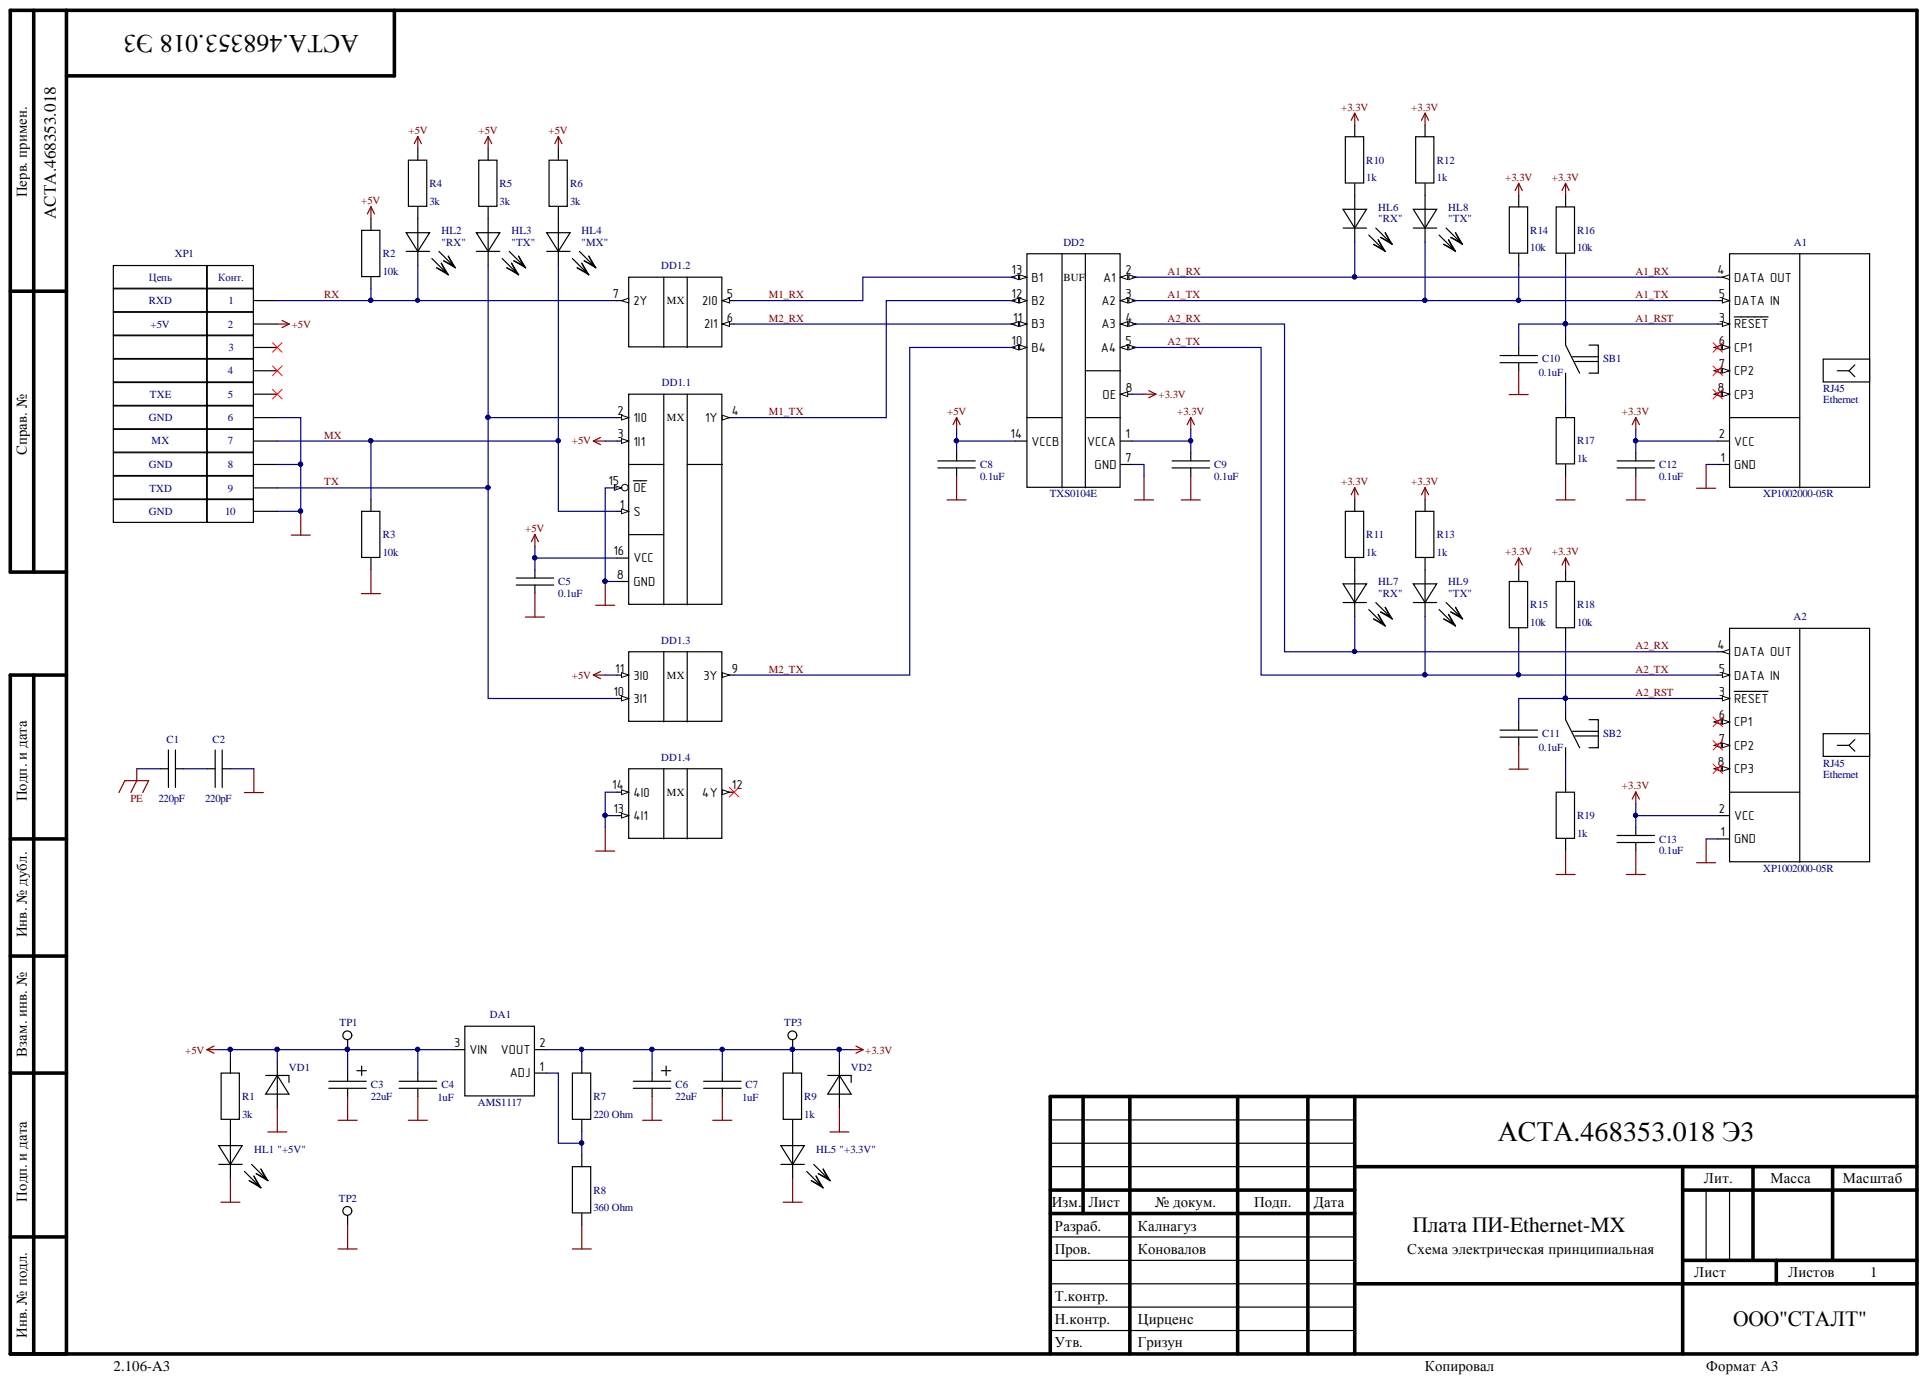
[picture p16: page 1]

Инв. № подл. Инв. № дубл. Подп. и дата Взам. инв. № Подп. и дата Перв. примен. Справ. №

MX GND TXD GND GND TXE +5V RXD

АСТА.4 6 8 3 5 3.0 1 8 Э 3

Плат а П И-Ethernet-MX Схе м а эле к триче с к а я принципиальна я | Лит . | Ма с с а | Ма сшт а б

Из м . | Лис т | № докум . | Подп . | Д а т а
Р а зра б . | | К ална гуз
Пров . | | Конов алов

Лис т | Лис тов 1

Т . конт р . | | | | | О О О "СТАЛТ "
Н . конт р . | Цирценс
У т в . | Гризун
