7taras/LantronixSTALT/Legacy/АСТА.468353.019 Плата UART-RS-485x2/АСТА.468353.019 Э3_00.pdf

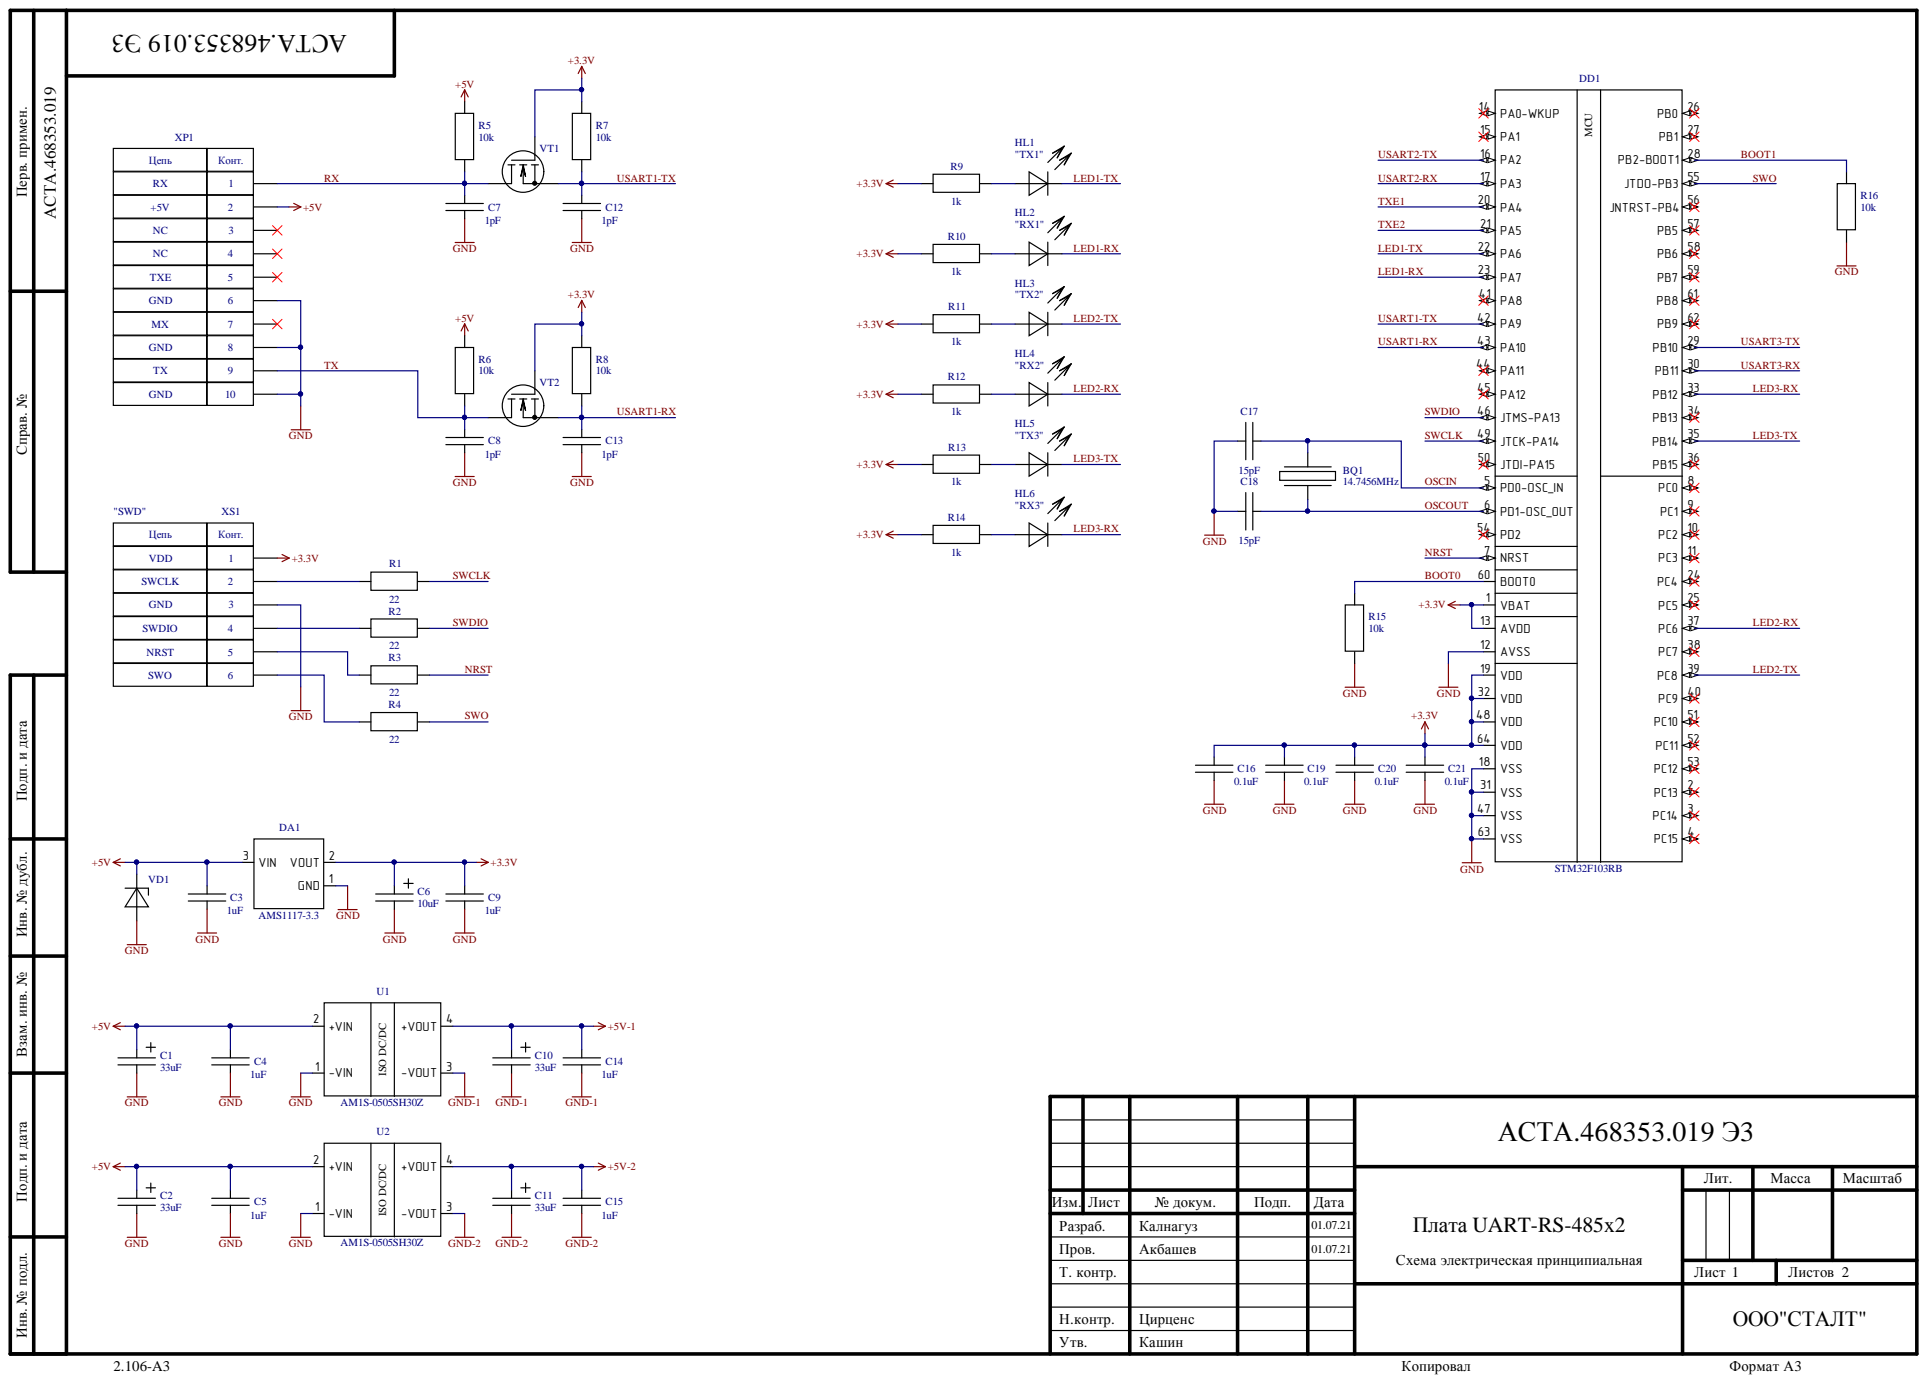
[picture p17: page 1]

Инв. № подл. Инв. № дубл. Подп. и дата Взам. инв. № Подп. и дата Перв. примен. Справ. №

MX GND TX GND GND NC TXE NC +5VRX

Ц епь | К онт .

SWC L K

Т . конт р . | Лис т 1 | Лис тов 2

Н . конт р . | Цирценс
У т в . | К ашин

О О О "СТАЛТ "

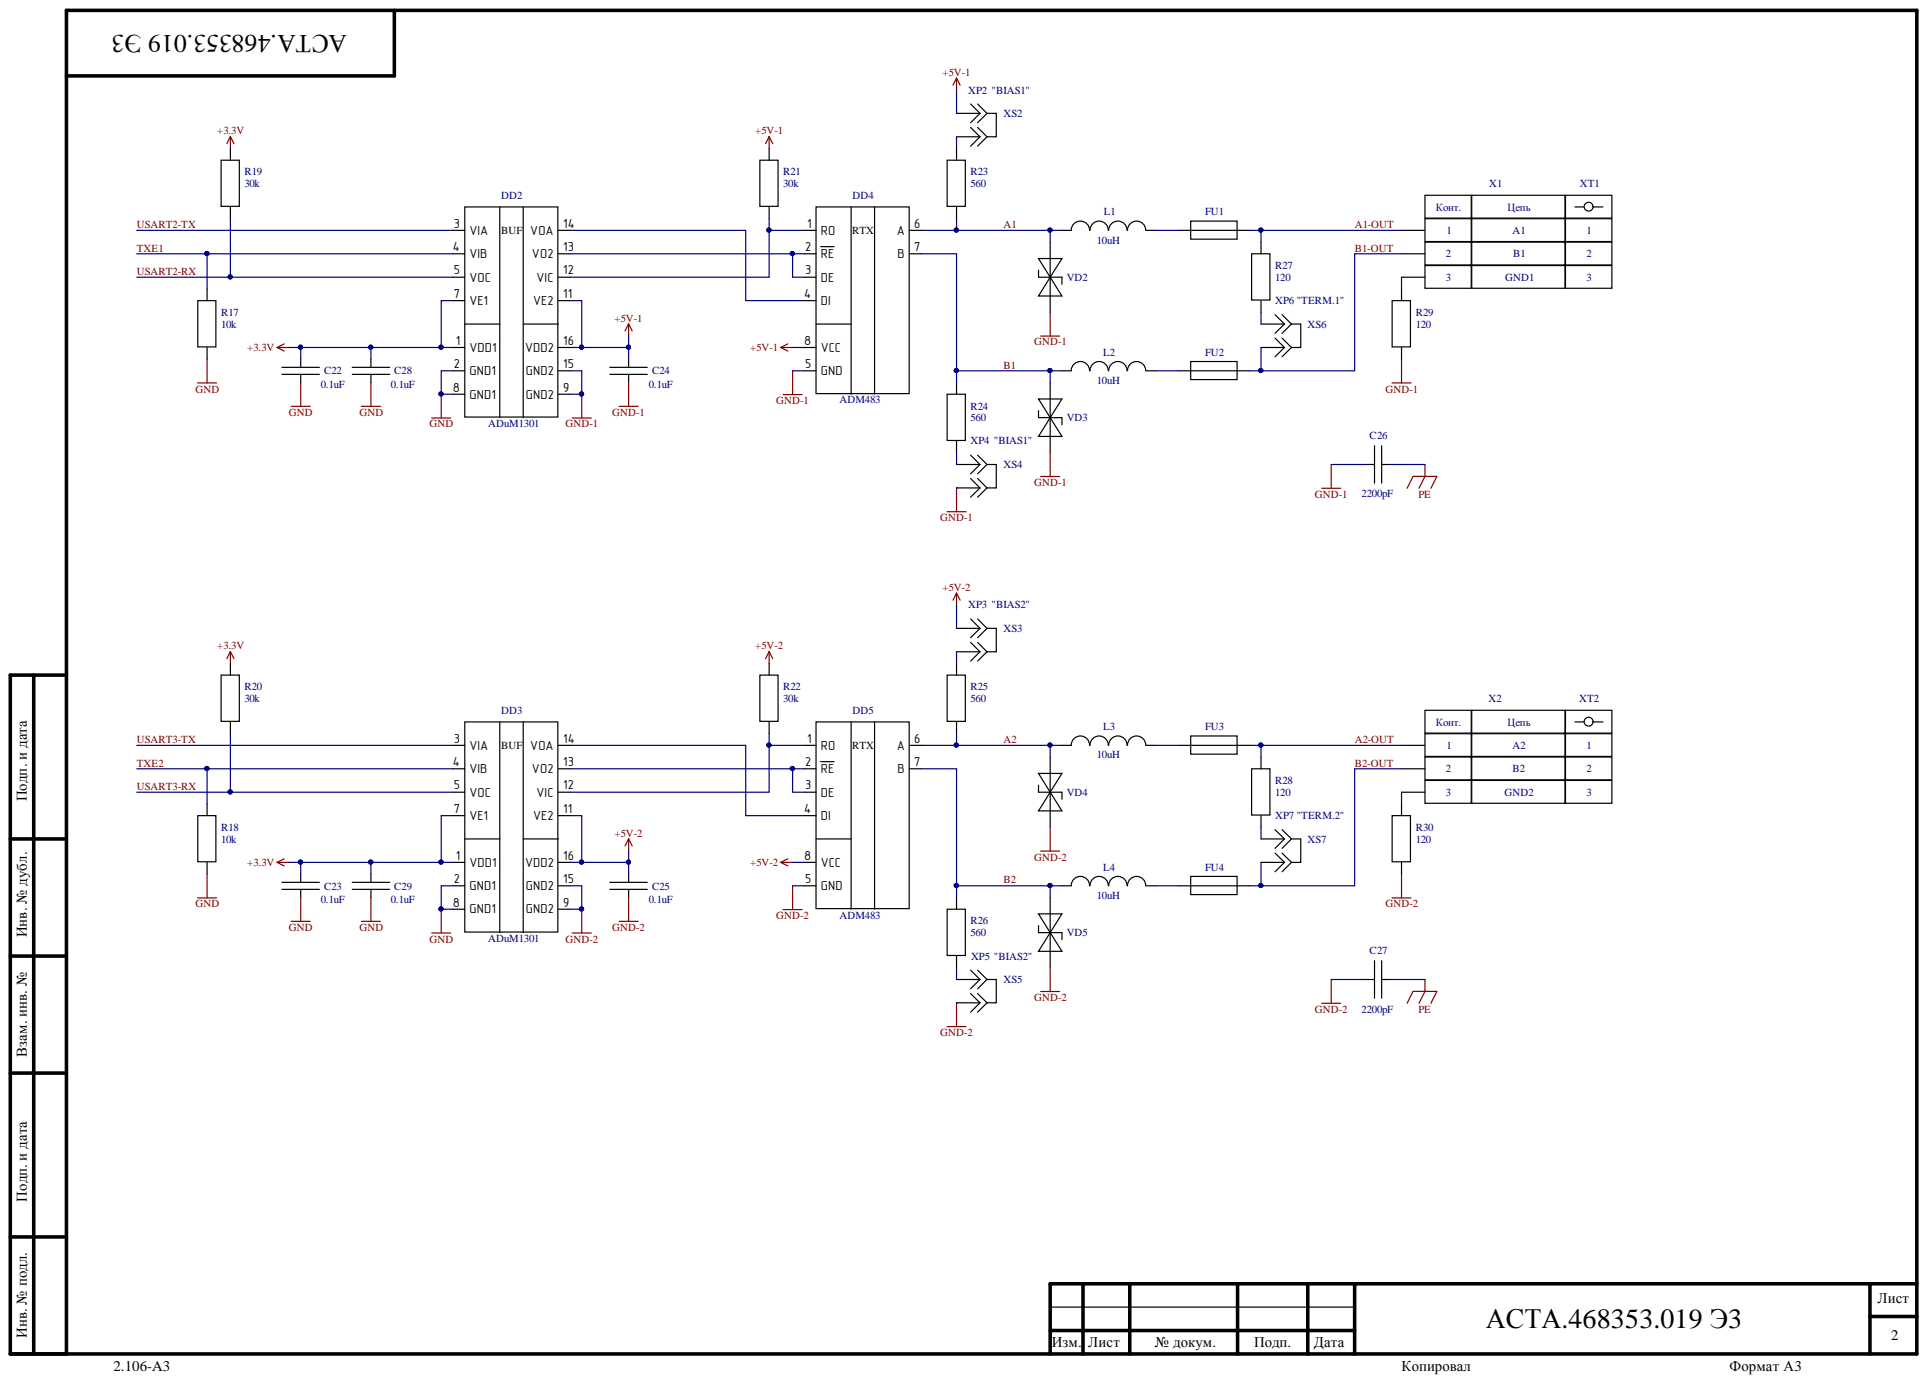
[picture p18: page 2]

К онт . | Ц епь | 312XT

Инв. № подл. Инв. № дубл. Подп. и дата Взам. инв. № Подп. и дата

К онт . | Ц епь
