7taras/LantronixSTALT/Legacy/АСТА.468353.016 Плата Пи-Ethernet/АСТА.468353.01 СБ_01.pdf

1 | Зам. АСТА.3062 Инв. № подл. Подп. и дата Взам. инв. № Инв. № дубл. Подп. и дата | 8864 ³⁰.10.20¹3 Справ. № Перв. примен. | АСТА.468353.0¹6

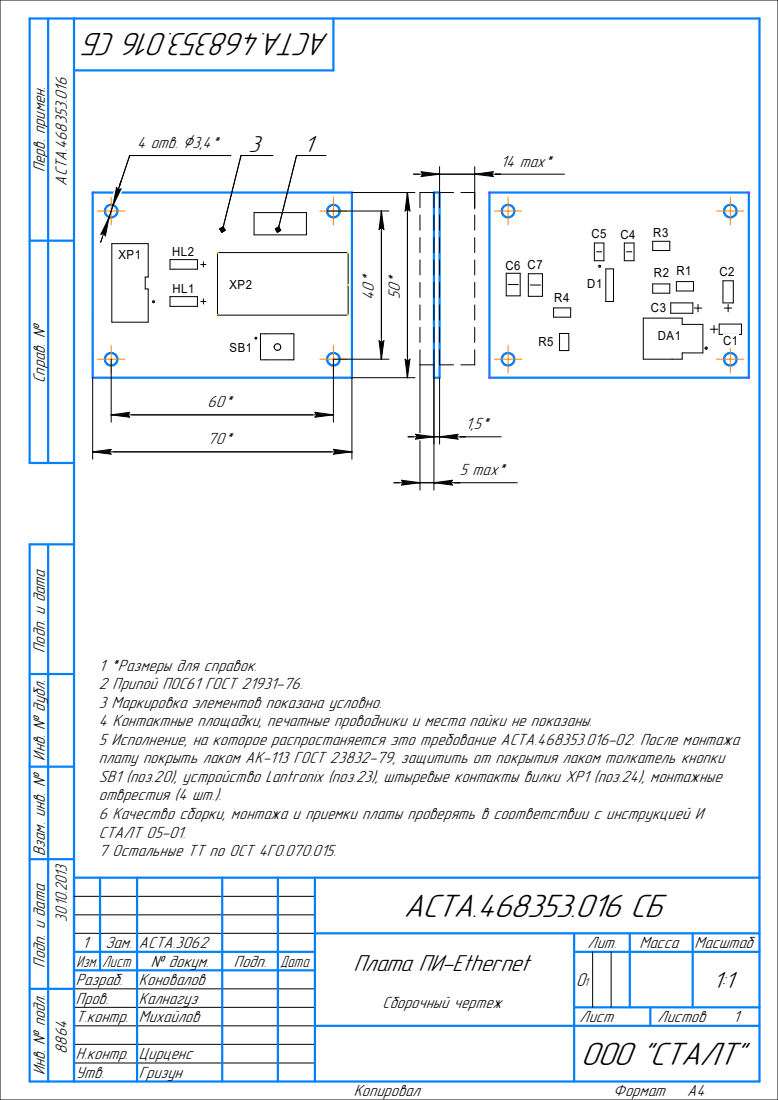
[picture p19: page 1]

14 max*

1 *Размеры для справок.
2 Припой ПОС61 ГОСТ 21931-76.
3 Маркировка элементов показана условно.
4 Контактные площадки, печатные проводники и места пайки не показаны.
5 Исполнение, на которое распростаняется это требование АСТА.468353.016-02. После монтажа
плату покрыть лаком АК-113 ГОСТ 23832-79, защитить от покрытия лаком толкатель кнопки
SB1 (поз.20), устройство Lantronix (поз.23), штыревые контакты вилки XP1 (поз.24), монтажные
отврестия (4 шт.).
6 Качество сборки, монтажа и приемки платы проверять в соответствии с инструкцией И
СТАЛТ 05-01.
7 Остальные ТТ по ОСТ 4ГО.070.015.

АСТА.468353.016 СБ

Плата ПИ-Ethernet Сборочный чертеж | Лит. | Масса | Масштаб

Изм. Лист | | № докум. | Подп. | Дата | | О1 | | | 1:1
Разраб. | | Коновалов
Пров. | Калнагуз
Т.контр. | Михайлов | | | | Лист | Листов 1

ООО "СТАЛТ"

Н.контр. | Цирценс
Утв. | Гризун
