7taras/LantronixSTALT/Legacy/АСТА.468353.016 Плата Пи-Ethernet/АСТА.468353.016-01 СБ_02.pdf

## 4 отв. 3,4

## 4 отв. 3,4

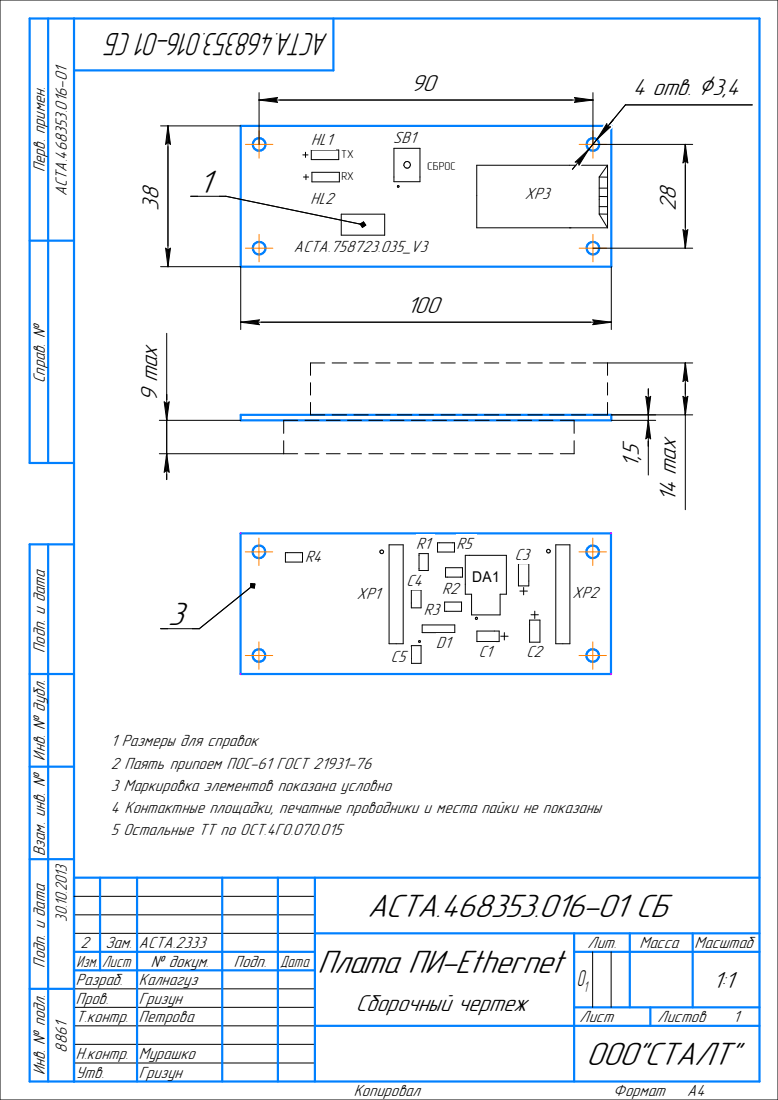
[picture p20: page 1]

1 Размеры для справок
2 Паять припоем ПОС-61 ГОСТ 21931-76
3 Маркировка элементов показана условно
4 Контактные площадки, печатные проводники и места пайки не показаны
5 Остальные ТТ по ОСТ.4Г0.070.015

АСТА.468353.016-01 СБ

2 Зам. АСТА.2333 | | | | | Плата ПИ-Ethernet Сборочный чертеж | Лит. | Масса | Масштаб
Изм. Лист | | № докум. | Подп. | Дата | | | | | 1:1
Разраб. | | Калнагуз
Пров. | Гризун
Т.контр. | Петрова | | | | Лист | Листов 1

ООО"СТАЛТ"

Н.контр. | Мурашко
Утв. | Гризун
