7taras/LantronixSTALT/Legacy/АСТА.468353.018 Плата ПИ-Ethernet-MX/АСТА.468353.018 СБ_00.pdf

1 2

1 2

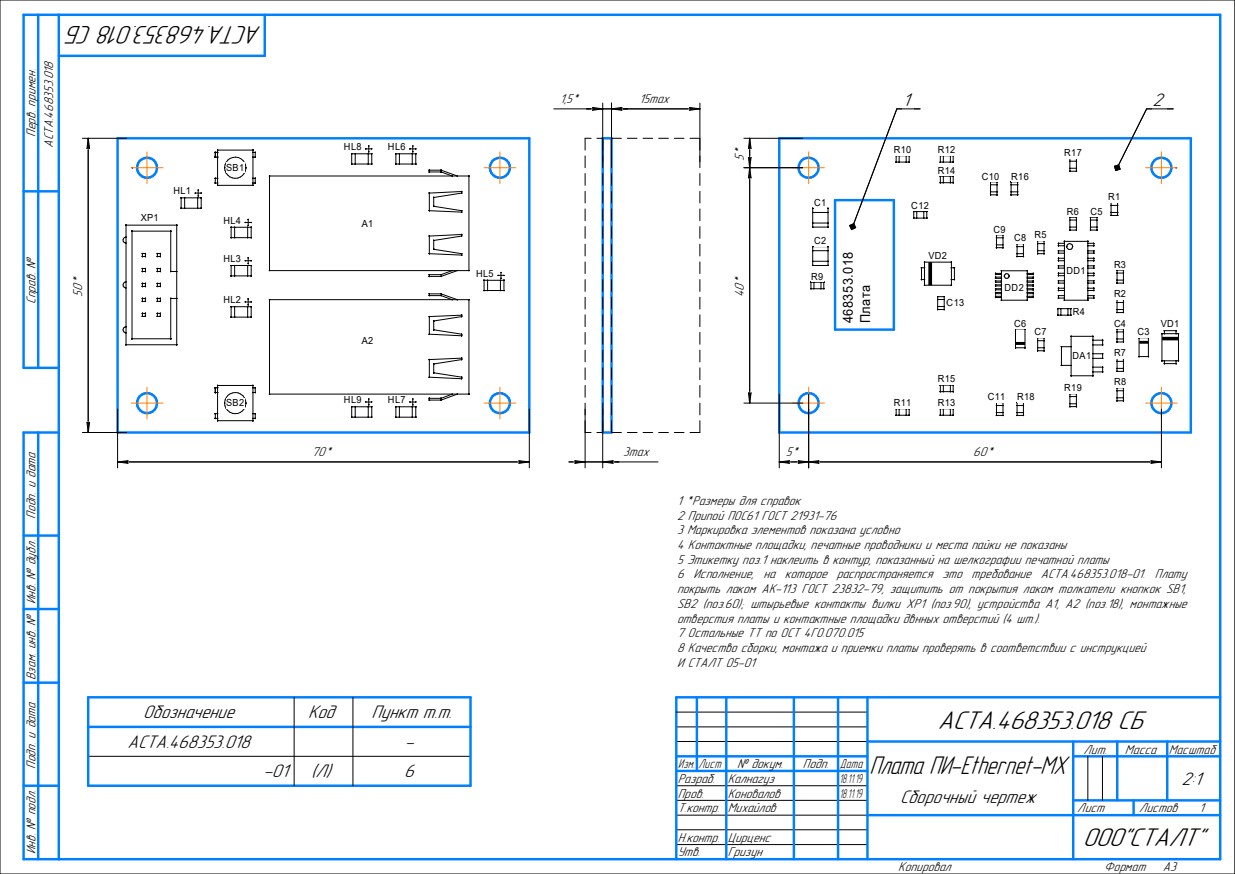
[picture p21: page 1]

18.11.19 Инв. № подл. Подп. и дата Взам. инв. № Инв. № дубл. Подп. и дата Справ. № Перв. примен. АСТА.468353.0¹8

1 *Размеры для справок
2 Припой ПОС61 ГОСТ 21931-76
3 Маркировка элементов показана условно
4 Контактные площадки, печатные проводники и места пайки не показаны
5 Этикетку поз.1 наклеить в контур, показанный на шелкографии печатной платы
6 Исполнение, на которое распространяется это требование АСТА.468353.018-01. Плату
покрыть лаком АК-113 ГОСТ 23832-79, защитить от покрытия лаком толкатели кнопкок SB1,
SB2 (поз.60); штырьевые контакты вилки XP1 (поз.90), устройства A1, A2 (поз.18), монтажные
отверстия платы и контактные площадки двнных отверстий (4 шт.).
7 Остальные ТТ по ОСТ 4ГО.070.015
8 Качество сборки, монтажа и приемки платы проверять в соответствии с инструкцией
И СТАЛТ 05-01

АСТА.468353.018 СБ
Плата ПИ-Ethernet-MX

Изм. Лист № докум. Подп. Дата
Разраб.
Пров.
