7taras/LantronixSTALT/(list of files, drawings)

Other design files:
Legacy/АСТА.468353.016 Плата Пи-Ethernet/АСТА.758723.034_V1.PcbDoc
Legacy/АСТА.468353.016 Плата Пи-Ethernet/АСТА.758723.035_V3.PcbDoc
Legacy/АСТА.468353.018 Плата ПИ-Ethernet-MX/АСТА.758723.037_V1.PcbDoc
Legacy/Плата ТО/АСТА.425543.043 Э3_01/АСТА.425543.043 Э3 Лист1.SchDoc
Legacy/Плата ТО/АСТА.425543.043 Э3_01/АСТА.425543.043 Э3 Лист2.SchDoc
Legacy/Плата ТО/АСТА.758725.047_V1/АСТА_758725_047_V1.pcb
Legacy/Плата ТО/АСТА.758725.047_V2/Mult_АСТА.758725.047_V2.PcbDoc
Legacy/Плата ТО/АСТА.758725.047_V2/АСТА.758725.047_V2.PcbDoc
Legacy/Плата ТО/АСТА.758725.047_V2/АСТА.758725.047_V2.PrjPcb
Project2/Sheet1_MCU.SchDoc
Project2/Sheet2_W5500.SchDoc
Project2/W5500-2.PrjPcb
Project2/W5500-2_V1.PcbDoc
Project3/Sheet1_MCU.SchDoc
Project3/Sheet2_W5500_1.SchDoc
Project3/Sheet3_W5500_2.SchDoc
Project3/W5500-3.PrjPcb
Project/Sheet1_MCU.SchDoc
Project/W5500.PrjPcb
Project/W5500_V1.PcbDoc
Project_v2/Sheet1_MCU.SchDoc
Project_v2/Sheet2_W5500.SchDoc
Project_v2/W5500.PrjPcb
STLINK/STLINK-SWD.SchDoc
STLINK/STLINK.PcbDoc
STLINK/STLINK.PrjPcb
STLINK/STLINK_MULT.PcbDoc
STLINK/UART-LA.SchDoc
