7taras/LantronixSTALT/STM32CubeIDE projects/W5500/Core/Src/main.cpp

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
/* Includes ------------------------------------------------------------------*/
#include "main.h"

/* USER CODE BEGIN Includes */
#include <stdlib.h>
#include <string.h>
#include "W5500.h"
#include "flashRW.h"
#include "dataProcessing.h"
/* USER CODE END Includes */

SPI_HandleTypeDef hspi1;

TIM_HandleTypeDef htim2;
TIM_HandleTypeDef htim3;
TIM_HandleTypeDef htim4;

UART_HandleTypeDef huart1;

/* USER CODE BEGIN PV */

CommonRegisterBlock crb {
	0, // uint8_t mr {0};		// offset 0x01
	0, // uint8_t gar0 {0};		// offset 0x01
	0, // uint8_t gar1 {0};		// offset 0x02
	0, // uint8_t gar2 {0};		// offset 0x03
	0, // uint8_t gar3 {0};		// offset 0x04
	255, // uint8_t subr0 {0};		// offset 0x05
	255, // uint8_t subr1 {0};		// offset 0x06
	255, // uint8_t subr2 {0};		// offset 0x07
	0, // uint8_t subr3 {0};		// offset 0x08
	0x00, //0x89, // uint8_t shar0 {0};		// offset 0x09
	0x20, //0xAB, // uint8_t shar1 {0};		// offset 0x0A
	0x4A, //0xCD, // uint8_t shar2 {0};		// offset 0x0B
	0xEB, //0xEF, // uint8_t shar3 {0};		// offset 0x0C
	0x03, //0, // uint8_t shar4 {0};		// offset 0x0D
	0x38, //0x02, // uint8_t shar5 {0};		// offset 0x0E
	10, // uint8_t sipr0 {0};		// offset 0x0F
	15, // uint8_t sipr1 {0};		// offset 0x10
	33, // uint8_t sipr2 {0};		// offset 0x11
	103, // uint8_t sipr3 {0};		// offset 0x12
	0, // uint8_t intlevel0 {0};	// offset 0x13
	0, // uint8_t intlevel1 {0};	// offset 0x14
	0, // uint8_t ir {0};			// offset 0x15
	0b11000000, // uint8_t imr {0};		// offset 0x16
	0, // uint8_t sir {0};		// offset 0x17
	0b00000111, // uint8_t simr {0};		// offset 0x18
	0x07, // uint8_t rtr0 {0x07};	// offset 0x19
	0xD0, // uint8_t rtr1 {0xD0};	// offset 0x1A
	0x08, // uint8_t rcr {0x08};		// offset 0x1B
	0x28, // uint8_t ptimer {0x28};	// offset 0x1C
	0, // uint8_t pmagic {0};		// offset 0x1D
	0, // uint8_t phar0 {0};		// offset 0x1E
	0, // uint8_t phar1 {0};		// offset 0x1F
	0, // uint8_t phar2 {0};		// offset 0x20
	0, // uint8_t phar3 {0};		// offset 0x21
	0, // uint8_t phar4 {0};		// offset 0x22
	0, // uint8_t phar5 {0};		// offset 0x23
	0, // uint8_t psid0 {0};		// offset 0x24
	0, // uint8_t psid1 {0};		// offset 0x25
	0xFF, // uint8_t pmru0 {0xFF};	// offset 0x26
	0xFF, // uint8_t pmru1 {0xFF};	// offset 0x27
	0, // uint8_t uipr0 {0};		// offset 0x28
	0, // uint8_t uipr1 {0};		// offset 0x29
	0, // uint8_t uipr2 {0};		// offset 0x2A
	0, // uint8_t uipr3 {0};		// offset 0x2B
	0, // uint8_t uportr0 {0};	// offset 0x2C
	0, // uint8_t uportr1 {0};	// offset 0x2D
	0b10111000, // uint8_t phycfgr {0b10111000};	// offset 0x2E
	0, // uint8_t reserved {0};	// offset 0x2F
};

CommonRegisterBlock crbDefault {
	0, // uint8_t mr {0};		// offset 0x01
	0, // uint8_t gar0 {0};		// offset 0x01
	0, // uint8_t gar1 {0};		// offset 0x02
	0, // uint8_t gar2 {0};		// offset 0x03
	0, // uint8_t gar3 {0};		// offset 0x04
	255, // uint8_t subr0 {0};		// offset 0x05
	255, // uint8_t subr1 {0};		// offset 0x06
	255, // uint8_t subr2 {0};		// offset 0x07
	0, // uint8_t subr3 {0};		// offset 0x08
	0x00, //0x89, // uint8_t shar0 {0};		// offset 0x09
	0x20, //0xAB, // uint8_t shar1 {0};		// offset 0x0A
	0x4A, //0xCD, // uint8_t shar2 {0};		// offset 0x0B
	0xEB, //0xEF, // uint8_t shar3 {0};		// offset 0x0C
	0x03, //0, // uint8_t shar4 {0};		// offset 0x0D
	0x38, //0x02, // uint8_t shar5 {0};		// offset 0x0E
	10, // uint8_t sipr0 {0};		// offset 0x0F
	15, // uint8_t sipr1 {0};		// offset 0x10
	33, // uint8_t sipr2 {0};		// offset 0x11
	103, // uint8_t sipr3 {0};		// offset 0x12
	0, // uint8_t intlevel0 {0};	// offset 0x13
	0, // uint8_t intlevel1 {0};	// offset 0x14
	0, // uint8_t ir {0};			// offset 0x15
	0b11000000, // uint8_t imr {0};		// offset 0x16
	0, // uint8_t sir {0};		// offset 0x17
	0b00000111, // uint8_t simr {0};		// offset 0x18
	0x07, // uint8_t rtr0 {0x07};	// offset 0x19
	0xD0, // uint8_t rtr1 {0xD0};	// offset 0x1A
	0x08, // uint8_t rcr {0x08};		// offset 0x1B
	0x28, // uint8_t ptimer {0x28};	// offset 0x1C
	0, // uint8_t pmagic {0};		// offset 0x1D
	0, // uint8_t phar0 {0};		// offset 0x1E
	0, // uint8_t phar1 {0};		// offset 0x1F
	0, // uint8_t phar2 {0};		// offset 0x20
	0, // uint8_t phar3 {0};		// offset 0x21
	0, // uint8_t phar4 {0};		// offset 0x22
	0, // uint8_t phar5 {0};		// offset 0x23
	0, // uint8_t psid0 {0};		// offset 0x24
	0, // uint8_t psid1 {0};		// offset 0x25
	0xFF, // uint8_t pmru0 {0xFF};	// offset 0x26
	0xFF, // uint8_t pmru1 {0xFF};	// offset 0x27
	0, // uint8_t uipr0 {0};		// offset 0x28
	0, // uint8_t uipr1 {0};		// offset 0x29
	0, // uint8_t uipr2 {0};		// offset 0x2A
	0, // uint8_t uipr3 {0};		// offset 0x2B
	0, // uint8_t uportr0 {0};	// offset 0x2C
	0, // uint8_t uportr1 {0};	// offset 0x2D
	0b10111000, // uint8_t phycfgr {0b10111000};	// offset 0x2E
	0, // uint8_t reserved {0};	// offset 0x2F
};

SocketRegisterBlock srb0 {
	0, // uint8_t sNmr {0};			// offset 0x00
	0, // uint8_t sNcr {0};			// offset 0x01
	0, // uint8_t sNir {0};			// offset 0x02
	0, // uint8_t sNsr {0};			// offset 0x03
	0x19, // uint8_t sNport0 {0};		// offset 0x04		// port 6500
	0x64, // uint8_t sNport1 {0};		// offset 0x05
	0xFF, //0x50, // uint8_t sNdhar0 {0xFF};		// offset 0x06	// 50-EB-F6-4D-BA-12
	0xFF, //0xEB, // uint8_t sNdhar1 {0xFF};		// offset 0x07
	0xFF, //0xF6, // uint8_t sNdhar2 {0xFF};		// offset 0x08
	0xFF, //0x4D, // uint8_t sNdhar3 {0xFF};		// offset 0x09
	0xFF, //0xBA, // uint8_t sNdhar4 {0xFF};		// offset 0x0A
	0xFF, //0x12, // uint8_t sNdhar5 {0xFF};		// offset 0x0B
	10, // uint8_t sNdipr0 {0};		// offset 0x0C
	15, // uint8_t sNdipr1 {0};		// offset 0x0D
	33, // uint8_t sNdipr2 {0};		// offset 0x0E
	1, // uint8_t sNdipr3 {0};		// offset 0x0F
	0x1D, // uint8_t sNdport0 {0};		// offset 0x10		// port 7500
	0x4C, // uint8_t sNdport1 {0};		// offset 0x11
	0, // uint8_t sNmssr0 {0};		// offset 0x12
	0, // uint8_t sNmssr1 {0};		// offset 0x13
	0, // uint8_t reserved14 {0};		// offset 0x14
	0, // uint8_t sNtos {0};			// offset 0x15
	0x80, // uint8_t sNttl {0x80};		// offset 0x16
	0, // uint8_t reserved17 {0};		// offset 0x17
	0, // uint8_t reserved18 {0};		// offset 0x18
	0, // uint8_t reserved19 {0};		// offset 0x19
	0, // uint8_t reserved1A {0};		// offset 0x1A
	0, // uint8_t reserved1B {0};		// offset 0x1B
	0, // uint8_t reserved1C {0};		// offset 0x1C
	0, // uint8_t reserved1D {0};		// offset 0x1D
	0x02, // uint8_t sNrxbufSize {0x02};	// offset 0x1E
	0x02, // uint8_t sNtxbufSize {0x02};	// offset 0x1F
	0x08, // uint8_t sNtxFsr0 {0x08};	// offset 0x20
	0, // uint8_t sNtxFsr1 {0};		// offset 0x21
	0, // uint8_t sNtxRd0 {0};		// offset 0x22
	0, // uint8_t sNtxRd1 {0};		// offset 0x23
	0, // uint8_t sNtxWr0 {0};		// offset 0x24
	0, // uint8_t sNtxWr1 {0};		// offset 0x25
	0, // uint8_t sNrxRsr0 {0};		// offset 0x26
	0, // uint8_t sNrxRsr1 {0};		// offset 0x27
	0, // uint8_t sNrxRd0 {0};		// offset 0x28
	0, // uint8_t sNrxRd1 {0};		// offset 0x29
	0, // uint8_t sNrxWr0 {0};		// offset 0x2A
	0, // uint8_t sNrxWr1 {0};		// offset 0x2B
	0xFF, // uint8_t sNimr {0xFF};		// offset 0x2C
	0x40, // uint8_t sNfrag0  {0x40};	// offset 0x2D
	0, // uint8_t sNfrag1 {0};		// offset 0x2E
	0, // uint8_t sNkpalvtr {0};		// offset 0x2F
};

SocketRegisterBlock srb0Default {
	0, // uint8_t sNmr {0};			// offset 0x00
	0, // uint8_t sNcr {0};			// offset 0x01
	0, // uint8_t sNir {0};			// offset 0x02
	0, // uint8_t sNsr {0};			// offset 0x03
	0x19, // uint8_t sNport0 {0};		// offset 0x04		// port 6500
	0x64, // uint8_t sNport1 {0};		// offset 0x05
	0xFF, //0x50, // uint8_t sNdhar0 {0xFF};		// offset 0x06	// 50-EB-F6-4D-BA-12
	0xFF, //0xEB, // uint8_t sNdhar1 {0xFF};		// offset 0x07
	0xFF, //0xF6, // uint8_t sNdhar2 {0xFF};		// offset 0x08
	0xFF, //0x4D, // uint8_t sNdhar3 {0xFF};		// offset 0x09
	0xFF, //0xBA, // uint8_t sNdhar4 {0xFF};		// offset 0x0A
	0xFF, //0x12, // uint8_t sNdhar5 {0xFF};		// offset 0x0B
	10, // uint8_t sNdipr0 {0};		// offset 0x0C
	15, // uint8_t sNdipr1 {0};		// offset 0x0D
	33, // uint8_t sNdipr2 {0};		// offset 0x0E
	1, // uint8_t sNdipr3 {0};		// offset 0x0F
	0x1D, // uint8_t sNdport0 {0};		// offset 0x10		// port 7500
	0x4C, // uint8_t sNdport1 {0};		// offset 0x11
	0, // uint8_t sNmssr0 {0};		// offset 0x12
	0, // uint8_t sNmssr1 {0};		// offset 0x13
	0, // uint8_t reserved14 {0};		// offset 0x14
	0, // uint8_t sNtos {0};			// offset 0x15
	0x80, // uint8_t sNttl {0x80};		// offset 0x16
	0, // uint8_t reserved17 {0};		// offset 0x17
	0, // uint8_t reserved18 {0};		// offset 0x18
	0, // uint8_t reserved19 {0};		// offset 0x19
	0, // uint8_t reserved1A {0};		// offset 0x1A
	0, // uint8_t reserved1B {0};		// offset 0x1B
	0, // uint8_t reserved1C {0};		// offset 0x1C
	0, // uint8_t reserved1D {0};		// offset 0x1D
	0x02, // uint8_t sNrxbufSize {0x02};	// offset 0x1E
	0x02, // uint8_t sNtxbufSize {0x02};	// offset 0x1F
	0x08, // uint8_t sNtxFsr0 {0x08};	// offset 0x20
	0, // uint8_t sNtxFsr1 {0};		// offset 0x21
	0, // uint8_t sNtxRd0 {0};		// offset 0x22
	0, // uint8_t sNtxRd1 {0};		// offset 0x23
	0, // uint8_t sNtxWr0 {0};		// offset 0x24
	0, // uint8_t sNtxWr1 {0};		// offset 0x25
	0, // uint8_t sNrxRsr0 {0};		// offset 0x26
	0, // uint8_t sNrxRsr1 {0};		// offset 0x27
	0, // uint8_t sNrxRd0 {0};		// offset 0x28
	0, // uint8_t sNrxRd1 {0};		// offset 0x29
	0, // uint8_t sNrxWr0 {0};		// offset 0x2A
	0, // uint8_t sNrxWr1 {0};		// offset 0x2B
	0xFF, // uint8_t sNimr {0xFF};		// offset 0x2C
	0x40, // uint8_t sNfrag0  {0x40};	// offset 0x2D
	0, // uint8_t sNfrag1 {0};		// offset 0x2E
	0, // uint8_t sNkpalvtr {0};		// offset 0x2F
};

SocketRegisterBlock srb1 {
	0, // uint8_t sNmr {0};			// offset 0x00
	0, // uint8_t sNcr {0};			// offset 0x01
	0, // uint8_t sNir {0};			// offset 0x02
	0, // uint8_t sNsr {0};			// offset 0x03
	0x19, // uint8_t sNport0 {0};		// offset 0x04		// port 6501
	0x65, // uint8_t sNport1 {0};		// offset 0x05
	0x50, // uint8_t sNdhar0 {0xFF};		// offset 0x06	// 50-EB-F6-4D-BA-12
	0xEB, // uint8_t sNdhar1 {0xFF};		// offset 0x07
	0xF6, // uint8_t sNdhar2 {0xFF};		// offset 0x08
	0x4D, // uint8_t sNdhar3 {0xFF};		// offset 0x09
	0xBA, // uint8_t sNdhar4 {0xFF};		// offset 0x0A
	0x12, // uint8_t sNdhar5 {0xFF};		// offset 0x0B
	10, // uint8_t sNdipr0 {0};		// offset 0x0C
	15, // uint8_t sNdipr1 {0};		// offset 0x0D
	33, // uint8_t sNdipr2 {0};		// offset 0x0E
	1, // uint8_t sNdipr3 {0};		// offset 0x0F
	0x1D, // uint8_t sNdport0 {0};		// offset 0x10		// port 7500
	0x4C, // uint8_t sNdport1 {0};		// offset 0x11
	0, // uint8_t sNmssr0 {0};		// offset 0x12
	0, // uint8_t sNmssr1 {0};		// offset 0x13
	0, // uint8_t reserved14 {0};		// offset 0x14
	0, // uint8_t sNtos {0};			// offset 0x15
	0x80, // uint8_t sNttl {0x80};		// offset 0x16
	0, // uint8_t reserved17 {0};		// offset 0x17
	0, // uint8_t reserved18 {0};		// offset 0x18
	0, // uint8_t reserved19 {0};		// offset 0x19
	0, // uint8_t reserved1A {0};		// offset 0x1A
	0, // uint8_t reserved1B {0};		// offset 0x1B
	0, // uint8_t reserved1C {0};		// offset 0x1C
	0, // uint8_t reserved1D {0};		// offset 0x1D
	0x02, // uint8_t sNrxbufSize {0x02};	// offset 0x1E
	0x02, // uint8_t sNtxbufSize {0x02};	// offset 0x1F
	0x08, // uint8_t sNtxFsr0 {0x08};	// offset 0x20
	0, // uint8_t sNtxFsr1 {0};		// offset 0x21
	0, // uint8_t sNtxRd0 {0};		// offset 0x22
	0, // uint8_t sNtxRd1 {0};		// offset 0x23
	0, // uint8_t sNtxWr0 {0};		// offset 0x24
	0, // uint8_t sNtxWr1 {0};		// offset 0x25
	0, // uint8_t sNrxRsr0 {0};		// offset 0x26
	0, // uint8_t sNrxRsr1 {0};		// offset 0x27
	0, // uint8_t sNrxRd0 {0};		// offset 0x28
	0, // uint8_t sNrxRd1 {0};		// offset 0x29
	0, // uint8_t sNrxWr0 {0};		// offset 0x2A
	0, // uint8_t sNrxWr1 {0};		// offset 0x2B
	0xFF, // uint8_t sNimr {0xFF};		// offset 0x2C
	0x40, // uint8_t sNfrag0  {0x40};	// offset 0x2D
	0, // uint8_t sNfrag1 {0};		// offset 0x2E
	0, // uint8_t sNkpalvtr {0};		// offset 0x2F
};

SocketRegisterBlock srb1Default {
	0, // uint8_t sNmr {0};			// offset 0x00
	0, // uint8_t sNcr {0};			// offset 0x01
	0, // uint8_t sNir {0};			// offset 0x02
	0, // uint8_t sNsr {0};			// offset 0x03
	0x19, // uint8_t sNport0 {0};		// offset 0x04		// port 6501
	0x65, // uint8_t sNport1 {0};		// offset 0x05
	0x50, // uint8_t sNdhar0 {0xFF};		// offset 0x06	// 50-EB-F6-4D-BA-12
	0xEB, // uint8_t sNdhar1 {0xFF};		// offset 0x07
	0xF6, // uint8_t sNdhar2 {0xFF};		// offset 0x08
	0x4D, // uint8_t sNdhar3 {0xFF};		// offset 0x09
	0xBA, // uint8_t sNdhar4 {0xFF};		// offset 0x0A
	0x12, // uint8_t sNdhar5 {0xFF};		// offset 0x0B
	10, // uint8_t sNdipr0 {0};		// offset 0x0C
	15, // uint8_t sNdipr1 {0};		// offset 0x0D
	33, // uint8_t sNdipr2 {0};		// offset 0x0E
	1, // uint8_t sNdipr3 {0};		// offset 0x0F
	0x1D, // uint8_t sNdport0 {0};		// offset 0x10		// port 7500
	0x4C, // uint8_t sNdport1 {0};		// offset 0x11
	0, // uint8_t sNmssr0 {0};		// offset 0x12
	0, // uint8_t sNmssr1 {0};		// offset 0x13
	0, // uint8_t reserved14 {0};		// offset 0x14
	0, // uint8_t sNtos {0};			// offset 0x15
	0x80, // uint8_t sNttl {0x80};		// offset 0x16
	0, // uint8_t reserved17 {0};		// offset 0x17
	0, // uint8_t reserved18 {0};		// offset 0x18
	0, // uint8_t reserved19 {0};		// offset 0x19
	0, // uint8_t reserved1A {0};		// offset 0x1A
	0, // uint8_t reserved1B {0};		// offset 0x1B
	0, // uint8_t reserved1C {0};		// offset 0x1C
	0, // uint8_t reserved1D {0};		// offset 0x1D
	0x02, // uint8_t sNrxbufSize {0x02};	// offset 0x1E
	0x02, // uint8_t sNtxbufSize {0x02};	// offset 0x1F
	0x08, // uint8_t sNtxFsr0 {0x08};	// offset 0x20
	0, // uint8_t sNtxFsr1 {0};		// offset 0x21
	0, // uint8_t sNtxRd0 {0};		// offset 0x22
	0, // uint8_t sNtxRd1 {0};		// offset 0x23
	0, // uint8_t sNtxWr0 {0};		// offset 0x24
	0, // uint8_t sNtxWr1 {0};		// offset 0x25
	0, // uint8_t sNrxRsr0 {0};		// offset 0x26
	0, // uint8_t sNrxRsr1 {0};		// offset 0x27
	0, // uint8_t sNrxRd0 {0};		// offset 0x28
	0, // uint8_t sNrxRd1 {0};		// offset 0x29
	0, // uint8_t sNrxWr0 {0};		// offset 0x2A
	0, // uint8_t sNrxWr1 {0};		// offset 0x2B
	0xFF, // uint8_t sNimr {0xFF};		// offset 0x2C
	0x40, // uint8_t sNfrag0  {0x40};	// offset 0x2D
	0, // uint8_t sNfrag1 {0};		// offset 0x2E
	0, // uint8_t sNkpalvtr {0};		// offset 0x2F
};

SocketRegisterBlock srb2 {
	0, // uint8_t sNmr {0};			// offset 0x00
	0, // uint8_t sNcr {0};			// offset 0x01
	0, // uint8_t sNir {0};			// offset 0x02
	0, // uint8_t sNsr {0};			// offset 0x03
	0x1E, // uint8_t sNport0 {0};		// offset 0x04		// port 7777
	0x61, // uint8_t sNport1 {0};		// offset 0x05
	0x50, // uint8_t sNdhar0 {0xFF};		// offset 0x06	// 50-EB-F6-4D-BA-12
	0xEB, // uint8_t sNdhar1 {0xFF};		// offset 0x07
	0xF6, // uint8_t sNdhar2 {0xFF};		// offset 0x08
	0x4D, // uint8_t sNdhar3 {0xFF};		// offset 0x09
	0xBA, // uint8_t sNdhar4 {0xFF};		// offset 0x0A
	0x12, // uint8_t sNdhar5 {0xFF};		// offset 0x0B
	10, // uint8_t sNdipr0 {0};		// offset 0x0C
	15, // uint8_t sNdipr1 {0};		// offset 0x0D
	33, // uint8_t sNdipr2 {0};		// offset 0x0E
	1, // uint8_t sNdipr3 {0};		// offset 0x0F
	0, // uint8_t sNdport0 {0};		// offset 0x10		// port 23
	23, // uint8_t sNdport1 {0};		// offset 0x11
	0, // uint8_t sNmssr0 {0};		// offset 0x12
	0, // uint8_t sNmssr1 {0};		// offset 0x13
	0, // uint8_t reserved14 {0};		// offset 0x14
	0, // uint8_t sNtos {0};			// offset 0x15
	0x80, // uint8_t sNttl {0x80};		// offset 0x16
	0, // uint8_t reserved17 {0};		// offset 0x17
	0, // uint8_t reserved18 {0};		// offset 0x18
	0, // uint8_t reserved19 {0};		// offset 0x19
	0, // uint8_t reserved1A {0};		// offset 0x1A
	0, // uint8_t reserved1B {0};		// offset 0x1B
	0, // uint8_t reserved1C {0};		// offset 0x1C
	0, // uint8_t reserved1D {0};		// offset 0x1D
	0x02, // uint8_t sNrxbufSize {0x02};	// offset 0x1E
	0x02, // uint8_t sNtxbufSize {0x02};	// offset 0x1F
	0x08, // uint8_t sNtxFsr0 {0x08};	// offset 0x20
	0, // uint8_t sNtxFsr1 {0};		// offset 0x21
	0, // uint8_t sNtxRd0 {0};		// offset 0x22
	0, // uint8_t sNtxRd1 {0};		// offset 0x23
	0, // uint8_t sNtxWr0 {0};		// offset 0x24
	0, // uint8_t sNtxWr1 {0};		// offset 0x25
	0, // uint8_t sNrxRsr0 {0};		// offset 0x26
	0, // uint8_t sNrxRsr1 {0};		// offset 0x27
	0, // uint8_t sNrxRd0 {0};		// offset 0x28
	0, // uint8_t sNrxRd1 {0};		// offset 0x29
	0, // uint8_t sNrxWr0 {0};		// offset 0x2A
	0, // uint8_t sNrxWr1 {0};		// offset 0x2B
	0xFF, // uint8_t sNimr {0xFF};		// offset 0x2C
	0x40, // uint8_t sNfrag0  {0x40};	// offset 0x2D
	0, // uint8_t sNfrag1 {0};		// offset 0x2E
	0, // uint8_t sNkpalvtr {0};		// offset 0x2F
};

SocketRegisterBlock srb2Default {
	0, // uint8_t sNmr {0};			// offset 0x00
	0, // uint8_t sNcr {0};			// offset 0x01
	0, // uint8_t sNir {0};			// offset 0x02
	0, // uint8_t sNsr {0};			// offset 0x03
	0x1E, // uint8_t sNport0 {0};		// offset 0x04		// port 7777
	0x61, // uint8_t sNport1 {0};		// offset 0x05
	0x50, // uint8_t sNdhar0 {0xFF};		// offset 0x06	// 50-EB-F6-4D-BA-12
	0xEB, // uint8_t sNdhar1 {0xFF};		// offset 0x07
	0xF6, // uint8_t sNdhar2 {0xFF};		// offset 0x08
	0x4D, // uint8_t sNdhar3 {0xFF};		// offset 0x09
	0xBA, // uint8_t sNdhar4 {0xFF};		// offset 0x0A
	0x12, // uint8_t sNdhar5 {0xFF};		// offset 0x0B
	10, // uint8_t sNdipr0 {0};		// offset 0x0C
	15, // uint8_t sNdipr1 {0};		// offset 0x0D
	33, // uint8_t sNdipr2 {0};		// offset 0x0E
	1, // uint8_t sNdipr3 {0};		// offset 0x0F
	0, // uint8_t sNdport0 {0};		// offset 0x10		// port 23
	23, // uint8_t sNdport1 {0};		// offset 0x11
	0, // uint8_t sNmssr0 {0};		// offset 0x12
	0, // uint8_t sNmssr1 {0};		// offset 0x13
	0, // uint8_t reserved14 {0};		// offset 0x14
	0, // uint8_t sNtos {0};			// offset 0x15
	0x80, // uint8_t sNttl {0x80};		// offset 0x16
	0, // uint8_t reserved17 {0};		// offset 0x17
	0, // uint8_t reserved18 {0};		// offset 0x18
	0, // uint8_t reserved19 {0};		// offset 0x19
	0, // uint8_t reserved1A {0};		// offset 0x1A
	0, // uint8_t reserved1B {0};		// offset 0x1B
	0, // uint8_t reserved1C {0};		// offset 0x1C
	0, // uint8_t reserved1D {0};		// offset 0x1D
	0x02, // uint8_t sNrxbufSize {0x02};	// offset 0x1E
	0x02, // uint8_t sNtxbufSize {0x02};	// offset 0x1F
	0x08, // uint8_t sNtxFsr0 {0x08};	// offset 0x20
	0, // uint8_t sNtxFsr1 {0};		// offset 0x21
	0, // uint8_t sNtxRd0 {0};		// offset 0x22
	0, // uint8_t sNtxRd1 {0};		// offset 0x23
	0, // uint8_t sNtxWr0 {0};		// offset 0x24
	0, // uint8_t sNtxWr1 {0};		// offset 0x25
	0, // uint8_t sNrxRsr0 {0};		// offset 0x26
	0, // uint8_t sNrxRsr1 {0};		// offset 0x27
	0, // uint8_t sNrxRd0 {0};		// offset 0x28
	0, // uint8_t sNrxRd1 {0};		// offset 0x29
	0, // uint8_t sNrxWr0 {0};		// offset 0x2A
	0, // uint8_t sNrxWr1 {0};		// offset 0x2B
	0xFF, // uint8_t sNimr {0xFF};		// offset 0x2C
	0x40, // uint8_t sNfrag0  {0x40};	// offset 0x2D
	0, // uint8_t sNfrag1 {0};		// offset 0x2E
	0, // uint8_t sNkpalvtr {0};		// offset 0x2F
};

SocketRegisterBlock srb3, srb4, srb5, srb6, srb7 {
	0, // uint8_t sNmr {0};			// offset 0x00
	0, // uint8_t sNcr {0};			// offset 0x01
	0, // uint8_t sNir {0};			// offset 0x02
	0, // uint8_t sNsr {0};			// offset 0x03
	0, // uint8_t sNport0 {0};		// offset 0x04
	0, // uint8_t sNport1 {0};		// offset 0x05
	0xFF, // uint8_t sNdhar0 {0xFF};		// offset 0x06
	0xFF, // uint8_t sNdhar1 {0xFF};		// offset 0x07
	0xFF, // uint8_t sNdhar2 {0xFF};		// offset 0x08
	0xFF, // uint8_t sNdhar3 {0xFF};		// offset 0x09
	0xFF, // uint8_t sNdhar4 {0xFF};		// offset 0x0A
	0xFF, // uint8_t sNdhar5 {0xFF};		// offset 0x0B
	0, // uint8_t sNdipr0 {0};		// offset 0x0C
	0, // uint8_t sNdipr1 {0};		// offset 0x0D
	0, // uint8_t sNdipr2 {0};		// offset 0x0E
	0, // uint8_t sNdipr3 {0};		// offset 0x0F
	0, // uint8_t sNdport0 {0};		// offset 0x10
	0, // uint8_t sNdport1 {0};		// offset 0x11
	0, // uint8_t sNmssr0 {0};		// offset 0x12
	0, // uint8_t sNmssr1 {0};		// offset 0x13
	0, // uint8_t reserved14 {0};		// offset 0x14
	0, // uint8_t sNtos {0};			// offset 0x15
	0x80, // uint8_t sNttl {0x80};		// offset 0x16
	0, // uint8_t reserved17 {0};		// offset 0x17
	0, // uint8_t reserved18 {0};		// offset 0x18
	0, // uint8_t reserved19 {0};		// offset 0x19
	0, // uint8_t reserved1A {0};		// offset 0x1A
	0, // uint8_t reserved1B {0};		// offset 0x1B
	0, // uint8_t reserved1C {0};		// offset 0x1C
	0, // uint8_t reserved1D {0};		// offset 0x1D
	0x02, // uint8_t sNrxbufSize {0x02};	// offset 0x1E
	0x02, // uint8_t sNtxbufSize {0x02};	// offset 0x1F
	0x08, // uint8_t sNtxFsr0 {0x08};	// offset 0x20
	0, // uint8_t sNtxFsr1 {0};		// offset 0x21
	0, // uint8_t sNtxRd0 {0};		// offset 0x22
	0, // uint8_t sNtxRd1 {0};		// offset 0x23
	0, // uint8_t sNtxWr0 {0};		// offset 0x24
	0, // uint8_t sNtxWr1 {0};		// offset 0x25
	0, // uint8_t sNrxRsr0 {0};		// offset 0x26
	0, // uint8_t sNrxRsr1 {0};		// offset 0x27
	0, // uint8_t sNrxRd0 {0};		// offset 0x28
	0, // uint8_t sNrxRd1 {0};		// offset 0x29
	0, // uint8_t sNrxWr0 {0};		// offset 0x2A
	0, // uint8_t sNrxWr1 {0};		// offset 0x2B
	0xFF, // uint8_t sNimr {0xFF};		// offset 0x2C
	0x40, // uint8_t sNfrag0  {0x40};	// offset 0x2D
	0, // uint8_t sNfrag1 {0};		// offset 0x2E
	0, // uint8_t sNkpalvtr {0};		// offset 0x2F
};

SocketRegisterBlock srb3_7Default {
	0, // uint8_t sNmr {0};			// offset 0x00
	0, // uint8_t sNcr {0};			// offset 0x01
	0, // uint8_t sNir {0};			// offset 0x02
	0, // uint8_t sNsr {0};			// offset 0x03
	0, // uint8_t sNport0 {0};		// offset 0x04
	0, // uint8_t sNport1 {0};		// offset 0x05
	0xFF, // uint8_t sNdhar0 {0xFF};		// offset 0x06
	0xFF, // uint8_t sNdhar1 {0xFF};		// offset 0x07
	0xFF, // uint8_t sNdhar2 {0xFF};		// offset 0x08
	0xFF, // uint8_t sNdhar3 {0xFF};		// offset 0x09
	0xFF, // uint8_t sNdhar4 {0xFF};		// offset 0x0A
	0xFF, // uint8_t sNdhar5 {0xFF};		// offset 0x0B
	0, // uint8_t sNdipr0 {0};		// offset 0x0C
	0, // uint8_t sNdipr1 {0};		// offset 0x0D
	0, // uint8_t sNdipr2 {0};		// offset 0x0E
	0, // uint8_t sNdipr3 {0};		// offset 0x0F
	0, // uint8_t sNdport0 {0};		// offset 0x10
	0, // uint8_t sNdport1 {0};		// offset 0x11
	0, // uint8_t sNmssr0 {0};		// offset 0x12
	0, // uint8_t sNmssr1 {0};		// offset 0x13
	0, // uint8_t reserved14 {0};		// offset 0x14
	0, // uint8_t sNtos {0};			// offset 0x15
	0x80, // uint8_t sNttl {0x80};		// offset 0x16
	0, // uint8_t reserved17 {0};		// offset 0x17
	0, // uint8_t reserved18 {0};		// offset 0x18
	0, // uint8_t reserved19 {0};		// offset 0x19
	0, // uint8_t reserved1A {0};		// offset 0x1A
	0, // uint8_t reserved1B {0};		// offset 0x1B
	0, // uint8_t reserved1C {0};		// offset 0x1C
	0, // uint8_t reserved1D {0};		// offset 0x1D
	0x02, // uint8_t sNrxbufSize {0x02};	// offset 0x1E
	0x02, // uint8_t sNtxbufSize {0x02};	// offset 0x1F
	0x08, // uint8_t sNtxFsr0 {0x08};	// offset 0x20
	0, // uint8_t sNtxFsr1 {0};		// offset 0x21
	0, // uint8_t sNtxRd0 {0};		// offset 0x22
	0, // uint8_t sNtxRd1 {0};		// offset 0x23
	0, // uint8_t sNtxWr0 {0};		// offset 0x24
	0, // uint8_t sNtxWr1 {0};		// offset 0x25
	0, // uint8_t sNrxRsr0 {0};		// offset 0x26
	0, // uint8_t sNrxRsr1 {0};		// offset 0x27
	0, // uint8_t sNrxRd0 {0};		// offset 0x28
	0, // uint8_t sNrxRd1 {0};		// offset 0x29
	0, // uint8_t sNrxWr0 {0};		// offset 0x2A
	0, // uint8_t sNrxWr1 {0};		// offset 0x2B
	0xFF, // uint8_t sNimr {0xFF};		// offset 0x2C
	0x40, // uint8_t sNfrag0  {0x40};	// offset 0x2D
	0, // uint8_t sNfrag1 {0};		// offset 0x2E
	0, // uint8_t sNkpalvtr {0};		// offset 0x2F
};


uint8_t receivedByteUART {0};

uint8_t receivedPacketUART[256];

uint8_t receivedBytesUARTCounter {0};
// флаг о получении пакета по UART
bool receivedPacketUARTisReady {false};


uint8_t copiedReceivedPacketUART[256];

uint8_t copiedReceivedBytesUARTCounter {0};

// флаг о том что полученый пакет по UART необходимо отправить по UDP
bool needsTransmitUDP {false};
// флаг о том что полученый пакет по UART необходимо отправить по TCP
bool needsTransmitTCP {false};

bool needsOpenTCP {false};

bool needsOpenTelnet {false};

// флаг о получении пакета по UDP
bool socket0dataReady {false};
// буфер данных полученных по UDP
uint8_t receiveSocket0data[2054];
// размер данных полученных по UDP
uint16_t sizeOfReceiveSocket0data;

// флаг о получении пакета по TCP
bool socket1dataReady {false};
// буфер данных полученных по TCP
uint8_t receiveSocket1data[2054];
// размер данных полученных по TCP
uint16_t sizeOfReceiveSocket1data;

// флаг о получении пакета по Telnet
bool socket2dataReady {false};
// буфер данных полученных по Telnet
uint8_t receiveSocket2data[2054];
// размер данных полученных по Telnet
uint16_t sizeOfReceiveSocket2data;





char bufferTelnet[256];
char* ptrReadBufferTelnet = bufferTelnet;
char* ptrWriteBufferTelnet = bufferTelnet;
char* ptrEndBufferTelnet = &bufferTelnet[256];
uint8_t typedValueCounter {0};

uint32_t temp32;

uint8_t receivedIPAddress[4];
uint8_t receivedSubnetMask[4];
uint8_t receivedMACAddress[6];
//char receivedMACTelnet[12];
uint8_t counterMessages {0};

extern char* arrText[];
extern char text0[];
extern char textNotApply[];
extern char textApply[];

uint32_t tempCRBfromFlash[12];
uint32_t tim2counter {0};
uint32_t tim2fixCounter {0};
bool tim2status {false};
/* USER CODE END PV */

void SystemClock_Config(void);
static void MX_GPIO_Init(void);
static void MX_SPI1_Init(void);
static void MX_USART1_UART_Init(void);
static void MX_TIM4_Init(void);
static void MX_TIM3_Init(void);
static void MX_TIM2_Init(void);
/* USER CODE BEGIN 0 */

// Cоздаем интерфейc c чипом W5500
W5500 ethernetA1(&hspi1, W5500_CS_GPIO_Port, W5500_CS_Pin, W5500_RST_GPIO_Port, W5500_RST_Pin);

/* USER CODE END 0 */

/**
  * @brief  The application entry point.
  * @retval int
  */
int main(void)
{
  /* MCU Configuration--------------------------------------------------------*/

  /* Reset of all peripherals, Initializes the Flash interface and the Systick. */
  HAL_Init();

  /* Configure the system clock */
  SystemClock_Config();

  /* Initialize all configured peripherals */
  MX_GPIO_Init();
  MX_SPI1_Init();


  MX_USART1_UART_Init();
  MX_TIM4_Init();
  MX_TIM3_Init();
  MX_TIM2_Init();
  /* USER CODE BEGIN 2 */

  readCRBfromFlash(tempCRBfromFlash);
  if (tempCRBfromFlash[11] != 0xFFFFFFFF)
  {
	  uint32_t* pData32 = (uint32_t*) &crb;
	  for (unsigned int i = 0; i < 12; i++)
	  {
		  *(pData32 + i) = tempCRBfromFlash[i];
	  }
  }
  //writeFLASH();

  //readFLASH();

  //char temp[4];
  //utoa(crb.sipr0, temp, 4);
  //text0[23] = temp[0];

  fillText();


  ethernetA1.reset();


  ethernetA1.writeArrayToCRB(&crb.mr, 47, W5500_MR);

  HAL_Delay(10);


  //ethernetA1.writeByteToSRB(SOCKET0, W5500_Sn_MR_UDP | W5500_Sn_MR_MULTI_MFEN, W5500_Sn_MR);
  ethernetA1.writeByteToSRB(SOCKET0, W5500_Sn_MR_UDP, W5500_Sn_MR);


  ethernetA1.writeByteToSRB(SOCKET1, W5500_Sn_MR_TCP | W5500_Sn_MR_MULTI_MFEN, W5500_Sn_MR);


  ethernetA1.writeByteToSRB(SOCKET2, W5500_Sn_MR_TCP | W5500_Sn_MR_MULTI_MFEN, W5500_Sn_MR);


  ethernetA1.writeByteToSRB(SOCKET0, W5500_Sn_IMR_SEND_OK_OFF, W5500_Sn_IMR);


  ethernetA1.writeByteToSRB(SOCKET1, W5500_Sn_IMR_SEND_OK_OFF & W5500_Sn_IMR_CON_OFF, W5500_Sn_IMR);


  ethernetA1.writeByteToSRB(SOCKET2, W5500_Sn_IMR_SEND_OK_OFF, W5500_Sn_IMR);

  HAL_Delay(10);


  ethernetA1.writeArrayToSRB(SOCKET0, &srb0.sNport0, 14, W5500_Sn_PORT);


  ethernetA1.writeArrayToSRB(SOCKET1, &srb1.sNport0, 14, W5500_Sn_PORT);


  ethernetA1.writeArrayToSRB(SOCKET2, &srb2.sNport0, 14, W5500_Sn_PORT);

  HAL_Delay(10);


  ethernetA1.writeByteToSRB(SOCKET0, W5500_Sn_CR_OPEN, W5500_Sn_CR);


  ethernetA1.writeByteToSRB(SOCKET1, W5500_Sn_CR_OPEN, W5500_Sn_CR);


  ethernetA1.writeByteToSRB(SOCKET2, W5500_Sn_CR_OPEN, W5500_Sn_CR);

  HAL_Delay(1);


  if (ethernetA1.readByteFromSRB(SOCKET1, W5500_Sn_SR) == W5500_Sn_SR_SOCK_INIT)
  {
	  ethernetA1.writeByteToSRB(SOCKET1, W5500_Sn_CR_LISTEN, W5500_Sn_CR);
  }


  if (ethernetA1.readByteFromSRB(SOCKET2, W5500_Sn_SR) == W5500_Sn_SR_SOCK_INIT)
  {
	  ethernetA1.writeByteToSRB(SOCKET2, W5500_Sn_CR_LISTEN, W5500_Sn_CR);
  }

  HAL_Delay(1);

  // Разрешаем прием по UART
  HAL_UART_Receive_IT(&huart1, &receivedByteUART, 1);

  // очищаем флаги прерываний
  CLEAR_BIT(TIM2->SR, TIM_SR_UIF);
  CLEAR_BIT(TIM3->SR, TIM_SR_UIF);
  CLEAR_BIT(TIM4->SR, TIM_SR_UIF);


  HAL_TIM_Base_Start_IT(&htim2);

  /* USER CODE END 2 */

  /* Infinite loop */
  /* USER CODE BEGIN WHILE */
  while (1)
  {

	  if (socket0dataReady)
	  {
		  if((HAL_UART_GetState(&huart1) == HAL_UART_STATE_READY) || (HAL_UART_GetState(&huart1) == HAL_UART_STATE_BUSY_RX))
		  {
			  //// изначально было TX
			  HAL_GPIO_WritePin(LED_RX_GPIO_Port, LED_RX_Pin, GPIO_PIN_RESET);
			  HAL_UART_Transmit_IT(&huart1, &receiveSocket0data[8], (sizeOfReceiveSocket0data-8));

			  socket0dataReady = false;
		  }
	  }


	  if (socket1dataReady)
	  {
		  if((HAL_UART_GetState(&huart1) == HAL_UART_STATE_READY) || (HAL_UART_GetState(&huart1) == HAL_UART_STATE_BUSY_RX))
		  {
			  //// изначально было TX
			  HAL_GPIO_WritePin(LED_RX_GPIO_Port, LED_RX_Pin, GPIO_PIN_RESET);
			  HAL_UART_Transmit_IT(&huart1, receiveSocket1data, sizeOfReceiveSocket1data);

			  socket1dataReady = false;
		  }
	  }


	  if (socket2dataReady)
	  {
		  for(int i = 0; i < sizeOfReceiveSocket2data; ++i)
		  {
			  if (ptrWriteBufferTelnet <= ptrEndBufferTelnet)
			  {
				  *ptrWriteBufferTelnet = receiveSocket2data[i];
				  ++ptrWriteBufferTelnet;
			  }
		  }

		  if( *(ptrWriteBufferTelnet - 1) == '\n')
		  {
			  if (counterMessages < 4)
			  {
				  if (*ptrReadBufferTelnet == '\n' || *ptrReadBufferTelnet == '\r')
				  {
					  receivedIPAddress[counterMessages] = *(&crb.sipr0 + counterMessages);
				  }
				  else
				  {
					  temp32 = atoi(ptrReadBufferTelnet);
					  if (temp32 > 0 && temp32 < 256) receivedIPAddress[counterMessages] = (uint8_t)temp32;
					  else receivedIPAddress[counterMessages] = 0;

				  }
				  ++counterMessages;
				  ptrReadBufferTelnet = ptrWriteBufferTelnet;
			  }
			  else if (counterMessages < 8)
			  {
				  if (*ptrReadBufferTelnet == '\n' || *ptrReadBufferTelnet == '\r')
				  {
					  receivedSubnetMask[counterMessages - 4] = *(&crb.subr0 + counterMessages - 4);
				  }
				  else
				  {
					  temp32 = atoi(ptrReadBufferTelnet);
					  if (temp32 > 0 && temp32 < 256) receivedSubnetMask[counterMessages - 4] = (uint8_t)temp32;
					  else receivedSubnetMask[counterMessages - 4] = 0;
				  }
				  ++counterMessages;
				  ptrReadBufferTelnet = ptrWriteBufferTelnet;
			  }
			  else if (counterMessages < 14)
			  {
				  if (*ptrReadBufferTelnet == '\n' || *ptrReadBufferTelnet == '\r')
				  {
					  receivedMACAddress[counterMessages - 8] = *(&crb.shar0 + counterMessages - 8);
					  ptrReadBufferTelnet = ptrWriteBufferTelnet;
				  }
				  else
				  {
					  uint8_t tempCounter { 0 };
					  while (ptrReadBufferTelnet != ptrWriteBufferTelnet)
					  {
						  if (tempCounter == 0)
						  {
							  if (*ptrReadBufferTelnet >= '0' && *ptrReadBufferTelnet <= '9')
							  {
								  receivedMACAddress[counterMessages - 8] = (*ptrReadBufferTelnet - 48)*16;
								  ++tempCounter;
							  }
							  else if (*ptrReadBufferTelnet >= 'A' && *ptrReadBufferTelnet <= 'F')
							  {
								  receivedMACAddress[counterMessages - 8] = (*ptrReadBufferTelnet - 55)*16;
								  ++tempCounter;
							  }
							  else if (*ptrReadBufferTelnet >= 'a' && *ptrReadBufferTelnet <= 'f')
							  {
								  receivedMACAddress[counterMessages - 8] = (*ptrReadBufferTelnet - 87)*16;
								  ++tempCounter;
							  }
						  }
						  else if (tempCounter == 1)
						  {
							  if (*ptrReadBufferTelnet >= '0' && *ptrReadBufferTelnet <= '9')
							  {
								  receivedMACAddress[counterMessages - 8] += (*ptrReadBufferTelnet - 48);
								  ++tempCounter;
							  }
							  else if (*ptrReadBufferTelnet >= 'A' && *ptrReadBufferTelnet <= 'F')
							  {
								  receivedMACAddress[counterMessages - 8] += (*ptrReadBufferTelnet - 55);
								  ++tempCounter;
							  }
							  else if (*ptrReadBufferTelnet >= 'a' && *ptrReadBufferTelnet <= 'f')
							  {
								  receivedMACAddress[counterMessages - 8] += (*ptrReadBufferTelnet - 87);
								  ++tempCounter;
							  }
						  }
						  ++ptrReadBufferTelnet;
					  }
				  }
				  ++counterMessages;
			  }
			  else if (counterMessages == 14)
			  {
				  if (*ptrReadBufferTelnet == 'Y' || *ptrReadBufferTelnet == 'y')
				  {
					  ethernetA1.sendString(SOCKET2, textApply);
					  saveSettings();
				  }
				  else
				  {
					  ethernetA1.sendString(SOCKET2, textNotApply);

				  }
			  }

			  if(typedValueCounter == 13)
			  {
				  fillFinalText();
			  }
			  else if (typedValueCounter == 15)
			  {
				  ethernetA1.writeByteToSRB(SOCKET2, W5500_Sn_CR_DISCON, W5500_Sn_CR);
			  }

			  if (typedValueCounter < 14)
			  {
				  ethernetA1.sendString(SOCKET2, arrText[typedValueCounter]);
			  }
			  ++typedValueCounter;
		  }
		  socket2dataReady = false;
	  }



	  if (receivedPacketUARTisReady)
	  {
		  if (needsTransmitUDP)
		  {

			  ethernetA1.sendPacket(SOCKET0, copiedReceivedPacketUART, copiedReceivedBytesUARTCounter);


			  receivedPacketUARTisReady = false;
			  needsTransmitUDP = false;
		  }

		  if (needsTransmitTCP)
		  {

			  ethernetA1.sendPacket(SOCKET1, copiedReceivedPacketUART, copiedReceivedBytesUARTCounter);


			  receivedPacketUARTisReady = false;
			  needsTransmitTCP = false;
		  }
	  }


	  if (needsOpenTCP)
	  {

		  ethernetA1.writeByteToSRB(SOCKET1, W5500_Sn_CR_OPEN, W5500_Sn_CR);

		  HAL_Delay(1);


		  if (ethernetA1.readByteFromSRB(SOCKET1, W5500_Sn_SR) == W5500_Sn_SR_SOCK_INIT)
		  {
			  ethernetA1.writeByteToSRB(SOCKET1, W5500_Sn_CR_LISTEN, W5500_Sn_CR);
		  }

		  needsOpenTCP = false;
	  }



	  if (needsOpenTelnet)
	  {

		  ethernetA1.writeByteToSRB(SOCKET2, W5500_Sn_CR_OPEN, W5500_Sn_CR);

		  HAL_Delay(1);


		  if (ethernetA1.readByteFromSRB(SOCKET2, W5500_Sn_SR) == W5500_Sn_SR_SOCK_INIT)
		  {
			  ethernetA1.writeByteToSRB(SOCKET2, W5500_Sn_CR_LISTEN, W5500_Sn_CR);
		  }

		  needsOpenTelnet = false;
	  }


/*
	  HAL_Delay(9000);
	  ethernetA1.readArrayFromSRB(SOCKET1, tempData, 48, W5500_Sn_MR);
	  if((HAL_UART_GetState(&huart1) == HAL_UART_STATE_READY) || (HAL_UART_GetState(&huart1) == HAL_UART_STATE_BUSY_RX))
	  {
		  HAL_GPIO_WritePin(LED_RX_GPIO_Port, LED_RX_Pin, GPIO_PIN_RESET);
		  HAL_UART_Transmit_IT(&huart1, tempData, 48);
	  }
	  HAL_Delay(1000);
	  ethernetA1.readArrayFromSRB(SOCKET2, tempData, 48, W5500_Sn_MR);
	  if((HAL_UART_GetState(&huart1) == HAL_UART_STATE_READY) || (HAL_UART_GetState(&huart1) == HAL_UART_STATE_BUSY_RX))
	  {
		  HAL_GPIO_WritePin(LED_RX_GPIO_Port, LED_RX_Pin, GPIO_PIN_RESET);
		  HAL_UART_Transmit_IT(&huart1, tempData, 48);
	  }
*/
    /* USER CODE END WHILE */

    /* USER CODE BEGIN 3 */
  }
  /* USER CODE END 3 */
}

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
/* USER CODE BEGIN 4 */
void HAL_UART_RxCpltCallback(UART_HandleTypeDef *huart)
{
  if (huart == &huart1)
  {
	  //// изначально было так - // включаем cветодиод "RX"
	  //// HAL_GPIO_WritePin(LED_RX_GPIO_Port, LED_RX_Pin, GPIO_PIN_RESET);

	  // включаем cветодиод "TX"
	  HAL_GPIO_WritePin(LED_TX_GPIO_Port, LED_TX_Pin, GPIO_PIN_RESET);


	  HAL_TIM_Base_Start_IT(&htim4);

	  //HAL_TIM_Base_Stop(&htim3);


	  __HAL_TIM_SET_COUNTER(&htim3, 0);


	  HAL_TIM_Base_Start_IT(&htim3);


	  receivedPacketUART[receivedBytesUARTCounter] = receivedByteUART;

	  //buf1.put(rxByte);


	  receivedBytesUARTCounter++;


	  HAL_UART_Receive_IT(&huart1, &receivedByteUART, 1);
  }
}

void HAL_UART_TxCpltCallback(UART_HandleTypeDef *huart) {
  if(huart == &huart1)
  {
	  //// изначально было так - // гаcим cветодиод "TX"
	  //// HAL_GPIO_WritePin(LED_TX_GPIO_Port, LED_TX_Pin, GPIO_PIN_SET);

	  // гаcим cветодиод "RX"
	  HAL_GPIO_WritePin(LED_RX_GPIO_Port, LED_RX_Pin, GPIO_PIN_SET);
  }
}

void HAL_TIM_PeriodElapsedCallback(TIM_HandleTypeDef *htim)
{
	if(htim->Instance == TIM2) //check if the interrupt comes from TIM2
	{
		//HAL_TIM_Base_Stop(&htim2); tim2fixCounter RSTBUTTON
		if(!HAL_GPIO_ReadPin(RSTBUTTON_GPIO_Port, RSTBUTTON_Pin))
		{
			if(!tim2status)
			{
				tim2fixCounter = tim2counter;
				tim2status = true;
			}
		}
		else
		{
			if(tim2status)
			{
				uint32_t pressTime = tim2counter - tim2fixCounter;
				if(pressTime > 50)
				{
					eraseFLASH();
					NVIC_SystemReset();
				}
				else if (pressTime > 10)
				{
					NVIC_SystemReset();
				}
				tim2status = false;
			}
		}
		++tim2counter;
	}
	if(htim->Instance == TIM3) //check if the interrupt comes from TIM3
	{
		HAL_TIM_Base_Stop(&htim3);

		// копируем полученный пакет
		for (int i = 0; i < receivedBytesUARTCounter; ++i)
		{
			copiedReceivedPacketUART[i] = receivedPacketUART[i];
		}

		copiedReceivedBytesUARTCounter = receivedBytesUARTCounter;


		receivedPacketUARTisReady = true;


		receivedBytesUARTCounter = 0;
	}
	if(htim->Instance == TIM4) //check if the interrupt comes from TIM4
	{
		HAL_TIM_Base_Stop(&htim4);

		//// изначально было так - // гаcим cветодиод "RX"
		//// HAL_GPIO_WritePin(LED_RX_GPIO_Port, LED_RX_Pin, GPIO_PIN_SET);

		// гаcим cветодиод "TX"
		HAL_GPIO_WritePin(LED_TX_GPIO_Port, LED_TX_Pin, GPIO_PIN_SET);
	}
}

void HAL_GPIO_EXTI_Callback(uint16_t GPIO_Pin)
{
	if(GPIO_Pin == W5500_INT_Pin)
	{

		uint8_t valueSIR = ethernetA1.readByteFromCRB(W5500_SIR);
		uint8_t valueSn_IR {0};
		if (valueSIR)
		{
			if (valueSIR & W5500_S0_INT)
			{

				valueSn_IR = ethernetA1.readByteFromSRB(SOCKET0, W5500_Sn_IR);

				if (valueSn_IR & W5500_Sn_IR_RECV) // получен пакет
				{
					// принимаем полученные данные
					ethernetA1.receivePacket(SOCKET0, receiveSocket0data, &sizeOfReceiveSocket0data);

					socket0dataReady = true;
					needsTransmitUDP = true;

					ethernetA1.writeByteToSRB(SOCKET0, W5500_Sn_IR_RECV, W5500_Sn_IR);
				}

				if (valueSn_IR & W5500_Sn_IR_SEND_OK) // команда SEND выполнена
				{

				}

				if (valueSn_IR & W5500_Sn_IR_CON)
				{

				}

				if (valueSn_IR & W5500_Sn_IR_DISCON) // от пира получен пакет FIN или FIN/ACK
				{

				}

				if (valueSn_IR & W5500_Sn_IR_TIMEOUT) // произошло ARPto или TCPto
				{

				}
			}

			if (valueSIR & W5500_S1_INT)
			{

				valueSn_IR = ethernetA1.readByteFromSRB(SOCKET1, W5500_Sn_IR);

				if (valueSn_IR & W5500_Sn_IR_RECV) // получен пакет
				{
					// принимаем полученные данные
					ethernetA1.receivePacket(SOCKET1, receiveSocket1data, &sizeOfReceiveSocket1data);

					socket1dataReady = true;
					needsTransmitTCP = true;

					ethernetA1.writeByteToSRB(SOCKET1, W5500_Sn_IR_RECV, W5500_Sn_IR);
				}

				if (valueSn_IR & W5500_Sn_IR_SEND_OK) // команда SEND выполнена
				{

				}

				if (valueSn_IR & W5500_Sn_IR_CON)
				{

				}

				if (valueSn_IR & W5500_Sn_IR_DISCON) // от пира получен пакет FIN или FIN/ACK
				{

					ethernetA1.writeByteToSRB(SOCKET1, W5500_Sn_CR_DISCON, W5500_Sn_CR);

					needsOpenTCP = true;

					ethernetA1.writeByteToSRB(SOCKET1, W5500_Sn_IR_DISCON, W5500_Sn_IR);
				}

				if (valueSn_IR & W5500_Sn_IR_TIMEOUT) // произошло ARPto или TCPto
				{

				}
			}

			if (valueSIR & W5500_S2_INT)
			{

				valueSn_IR = ethernetA1.readByteFromSRB(SOCKET2, W5500_Sn_IR);

				if (valueSn_IR & W5500_Sn_IR_RECV) // получен пакет
				{
					// принимаем полученные данные
					ethernetA1.receivePacket(SOCKET2, receiveSocket2data, &sizeOfReceiveSocket2data);

					socket2dataReady = true;
					//needsTransmitTCP = true;

					ethernetA1.writeByteToSRB(SOCKET2, W5500_Sn_IR_RECV, W5500_Sn_IR);
				}

				if (valueSn_IR & W5500_Sn_IR_SEND_OK) // команда SEND выполнена
				{

				}

				if (valueSn_IR & W5500_Sn_IR_CON)
				{
					counterMessages = 0;
					typedValueCounter = 0;
					ptrReadBufferTelnet = bufferTelnet;
					ptrWriteBufferTelnet = bufferTelnet;
					ethernetA1.sendString(SOCKET2, text0);

					ethernetA1.writeByteToSRB(SOCKET2, W5500_Sn_IR_CON, W5500_Sn_IR);
				}

				if (valueSn_IR & W5500_Sn_IR_DISCON) // от пира получен пакет FIN или FIN/ACK
				{

					ethernetA1.writeByteToSRB(SOCKET2, W5500_Sn_CR_DISCON, W5500_Sn_CR);

					needsOpenTelnet = true;

					ethernetA1.writeByteToSRB(SOCKET2, W5500_Sn_IR_DISCON, W5500_Sn_IR);
				}

				if (valueSn_IR & W5500_Sn_IR_TIMEOUT) // произошло ARPto или TCPto
				{

				}

			}


		}
	}
}

/* USER CODE END 4 */
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
