7taras/LantronixSTALT/STM32CubeIDE projects/W5500/Core/Inc/main.h

#define RSTBUTTON_Pin GPIO_PIN_15
#define RSTBUTTON_GPIO_Port GPIOC
#define W5500_INT_Pin GPIO_PIN_4
#define W5500_INT_GPIO_Port GPIOA
#define W5500_INT_EXTI_IRQn EXTI4_IRQn
#define W5500_RST_Pin GPIO_PIN_4
#define W5500_RST_GPIO_Port GPIOC
#define W5500_CS_Pin GPIO_PIN_5
#define W5500_CS_GPIO_Port GPIOC
#define LED_TX_Pin GPIO_PIN_8
#define LED_TX_GPIO_Port GPIOB
#define LED_RX_Pin GPIO_PIN_9
#define LED_RX_GPIO_Port GPIOB
