7taras/LantronixSTALT/(commit log)

2023-03-14 legacy & DS
    [АСТА.758723.034_V1.PcbDoc, АСТА.758723.035_V3.PcbDoc, АСТА.758723.037_V1.PcbDoc]
2023-03-21 Altium project
    [Sheet2_W5500.SchDoc]
2023-03-21 sheet1 & pcb added
    [Sheet1_MCU.SchDoc, Sheet2_W5500.SchDoc, W5500.PrjPcb, W5500_V1.PcbDoc]
2023-03-22 BOM added
    [BOM.xlsx]
2023-03-22 in process
    [Sheet1_MCU.SchDoc, Sheet2_W5500.SchDoc, W5500.PrjPcb, W5500_V1.PcbDoc]
2023-03-22 pcb is designing
    [W5500_V1.PcbDoc]
2023-03-23 design finished
    [Sheet1_MCU.SchDoc, Sheet2_W5500.SchDoc, W5500.PrjPcb, W5500_V1.PcbDoc]
2023-03-23 LED added
2023-03-24 PCB project
    [Sheet1_MCU.SchDoc, Sheet2_W5500.SchDoc, W5500.PrjPcb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]
2023-03-29 Add files via upload
    Final project
    [Sheet1_MCU.SchDoc, Sheet2_W5500.SchDoc, W5500.PrjPcb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]
2023-04-10 assembly added
2023-04-17 two variants pcb else added
    [Sheet1_MCU.SchDoc, Sheet2_W5500.SchDoc, Sheet2_W5500_1.SchDoc, Sheet3_W5500_2.SchDoc, W5500-2.PrjPcb, W5500-2_V1.PcbDoc, W5500-3.PrjPcb]
2023-04-17 RJ45 inside board
    [W5500-2_V1.PcbDoc]
2023-04-18 Assembly modified
2023-05-11 BQ1 to 12MHz changed
    [Sheet1_MCU.SchDoc, W5500-2_V1.PcbDoc, W5500-3.PrjPcb, W5500.PrjPcb]
2023-05-30 UDP (MAC) TCP (connecting) fixed
    [main.cpp]
2023-05-31 ST-Link V2 adapter PCB added
    [STLINK-SWD.SchDoc, STLINK.PcbDoc, STLINK.PrjPcb, STLINK_MULT.PcbDoc, UART-LA.SchDoc]
2023-05-31 BOM modified
2023-05-31 Docs added
    [Sheet1_MCU.SchDoc, Sheet2_W5500.SchDoc, W5500-2.PrjPcb, W5500-2_V1.PcbDoc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]
2023-06-14 V2 added
    [Sheet1_MCU.SchDoc, Sheet2_W5500.SchDoc, W5500.PrjPcb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]
